ppthanh2810/capstone_project/stage3_navigation/README.md

# `stage3_navigation`: lập đường A\* + DWB tự né vật cản

Package này giúp robot **tự đi tới một đích** chọn trên RViz, theo hai lớp:

| Lớp | Làm gì | Biết gì |
|---|---|---|
| **A\*** (toàn cục) | Tìm **một** đường từ robot tới đích, **một lần** cho mỗi goal | Chỉ bản đồ tĩnh (`/map`) |
| **DWB** (cục bộ) | Mỗi 0.1 s chọn vận tốc (v, ω) để bám đường A\* và **tự né vật cản** | Vật cản LiDAR đang thấy (local costmap 2 × 2 m) |

- **Không có replanning.** Đường A\* không đổi trong cả lần bám. Vật cản mới chỉ do DWB xử lý (mục 9).
- Bộ điều khiển mặc định là **CustomDWB** (`stage3_navigation::DwbController`, tự viết). Nav2 DWB vẫn giữ để so sánh.
- Tính năng replan (commit `0d553eb`, 2026-10-15) đã được gỡ ngày 2026-10-19. Code và tham số CustomDWB = bản trước đó
  (`a7c59a1`), cộng cổng serial mới. Từ 2026-10-20 có thêm lớp camera (M2, `camera:=true`); ảnh camera hiện ngay trong `planning.rviz`.

> ⚠️ **Mọi launch ở đây đều include Stage 2**, nên bật LiDAR, IMU, **motor** và tay PS4 (trừ `stage2:=false`).
> `navigation_enabled:=false` (mặc định) chỉ ngắt **lệnh của DWB** khỏi motor; tay PS4 vẫn lái được.
> `navigation_enabled:=true` (DWB lái motor thật): kê bánh / giữ E-stop.

---

## Mục lục
1. Các file chính
2. Kiến trúc và luồng dữ liệu
   - 2.1 Sơ đồ tổng
   - 2.2 Node của stage 3
   - 2.3 Topic, action, service chính
   - 2.4 Lifecycle (thứ tự bật)
3. `launch/planning.launch.py`: chỉ lập đường A\*
4. `launch/navigation.launch.py`: A\* + DWB
5. Các trường hợp chạy
   - 5.1 Quy trình chuẩn (C hoặc D)
   - 5.2 Lưu ý cho chế độ C (cách ly)
   - 5.3 Rollout trên robot (theo thứ tự)
6. `config/nav2_params.yaml`: tham số
   - 6.1 `planner_server` (A\*)
   - 6.2 `global_costmap` (cho A\*)
   - 6.3 `controller_server`
   - 6.4 `CustomDWB` (`stage3_navigation::DwbController`)
   - 6.5 `FollowPath` (Nav2 DWB, để so sánh)
   - 6.6 `local_costmap` (cho DWB)
   - 6.7 Lớp camera trong `local_costmap` (M2, tùy chọn)
   - 6.8 `goal_path_bridge`
7. `goal_path_bridge`: phân tích chi tiết
   - 7.1 Nhận goal (`onGoal`)
   - 7.2 Bắt đầu bám đường (`startFollow`)
   - 7.3 Trạng thái trên `/goal_path_bridge/follow_state`
   - 7.4 Giám sát (timer 200 ms, `watchFollow`, chỉ khi đang bám)
   - 7.5 Kết quả FollowPath
   - 7.6 Tắt node
8. CustomDWB: phân tích chi tiết
   - 8.1 Khi nhận đường (`setPlan`)
   - 8.2 Một chu kỳ (`computeVelocityCommands`, 10 Hz)
   - 8.3 controller_server làm gì với lỗi của plugin
   - 8.4 Sơ đồ luồng một chu kỳ
   - 8.5 Vòng phản hồi điều khiển
   - 8.6 Vai trò của từng nhóm tham số
   - 8.7 Ví dụ: CustomDWB xử lý khi gặp vật cản
   - 8.8 Quan hệ quan trọng khi tuning
9. DWB tự né vật cản
   - 9.1 Cơ chế
   - 9.2 Tuning 2026-10-21 (mô phỏng, chưa thử trên robot)
   - 9.3 Né được và không né được
   - 9.4 Tham số ảnh hưởng tới khả năng né
   - 9.5 Cách thử né vật cản trên robot
   - 9.6 Vật cản LiDAR không thấy: lớp camera (M2)
10. Các tình huống và cách hệ thống phản ứng
11. Thời gian truyền và phản hồi
12. Kết quả trên robot
13. Theo dõi và debug
14. Test
15. Giới hạn đã biết

---

## 1. Các file chính

| File | Vai trò |
|---|---|
| `launch/planning.launch.py` | Stage 2 + A\* + RViz (chỉ lập đường, **không** có DWB) |
| `launch/navigation.launch.py` | `planning.launch.py` + DWB + local costmap |
| `config/nav2_params.yaml` | Mọi tham số: planner, 2 costmap, bridge, controller, DWB |
| `src/goal_path_bridge.cpp` | Node điều phối: goal → A\* → FollowPath, giám sát |
| `src/dwa_core.cpp` | Thuật toán CustomDWB (không phụ thuộc ROS) |
| `src/dwb_controller.cpp` | Vỏ ROS của CustomDWB (plugin Nav2) |
| `include/stage3_navigation/dwa_core.hpp` | Tham số mặc định `DwbParams`, khai báo thuật toán |
| `include/stage3_navigation/dwb_controller.hpp` | Khai báo plugin |
| `dwb_controller_plugin.xml` | Đăng ký plugin với pluginlib |
| `src/camera_fusion.cpp` + `.hpp` | Luật hợp nhất camera + LiDAR (M2, không phụ thuộc ROS) |
| `src/fusion_layer.cpp` + `.hpp` | Plugin costmap `FusionLayer` (vỏ ROS) |
| `fusion_layer_plugin.xml` | Đăng ký `FusionLayer` với pluginlib |
| `config/camera_fusion.yaml` | Thêm `fusion_layer` vào local costmap (nạp chồng) |
| `config/camera_voxel.yaml` | Thêm `VoxelLayer` của Nav2 (đối chứng) |
| `launch/camera.launch.py` | Driver RealSense D435 (point cloud, không TF) |
| `rviz/planning.rviz` | RViz duy nhất: map, costmap, đường đi + ảnh màu, point cloud camera |

---

## 2. Kiến trúc và luồng dữ liệu

### 2.1 Sơ đồ tổng

```text
                       (Stage 2: AMCL hoặc slam_toolbox)        (Stage 1: EKF)
                          /map, TF map → odom              TF odom → base_footprint, /odometry/filtered
                                   │                                     │
RViz 2D Goal Pose ──/goal_pose──> goal_path_bridge ──action /compute_path_to_pose──> planner_server (A*)
                                   │   ▲                                               │ global_costmap
                                   │   └────────────── đường A* ───────────────────────┘ (static + inflation)
                                   │
                                   ├──> /global_path (RViz)
                                   │
            (chỉ khi ~/follow hoặc auto_follow)
                                   │
                                   └──action /follow_path──> controller_server (10 Hz)
                                                              │  plugin CustomDWB hoặc FollowPath (Nav2 DWB)
                                                              │  local_costmap ← /scan_filtered (né vật cản)
                                                              ▼
                                          "cmd_vel" ──> /cmd_vel_dwb  (navigation_enabled:=false, không ai nghe)
                                                   └──> /cmd_vel_nav  (navigation_enabled:=true)
                                                              │
                                                    twist_mux (ưu tiên 10; PS4 = 100)
                                                              │
                                                       /cmd_vel_out → zlac8015d_move → motor

/localization/status (monitor) ──> goal_path_bridge   (cho phép / hủy bám đường)
/global_costmap/costmap        ──> goal_path_bridge   (giải thích khi A* thất bại)
```

### 2.2 Node của stage 3

| Node | Có trong | Loại |
|---|---|---|
| `planner_server` (+ `global_costmap`) | planning, navigation | lifecycle |
| `lifecycle_manager_planning` | planning, navigation | – |
| `goal_path_bridge` | planning (A\* only) hoặc navigation (có FollowPath) | node thường |
| `controller_server` (+ `local_costmap`) | navigation | lifecycle |
| `lifecycle_manager_navigation` | navigation | – |
| `rviz2_planning` | cả hai (`rviz:=true`) | – |

Stage 3 **không phát TF**, không có BT navigator, không gọi `NavigateToPose`. Mọi thứ do `goal_path_bridge` điều phối.

### 2.3 Topic, action, service chính

| Tên | Loại | Từ → tới |
|---|---|---|
| `/goal_pose` | topic `PoseStamped` | RViz → bridge |
| `/compute_path_to_pose` | action | bridge → planner_server |
| `/global_path` | topic `Path` (transient_local) | bridge → RViz |
| `/plan` | topic `Path` | planner_server (tự phát) |
| `/follow_path` | action | bridge → controller_server |
| `/goal_path_bridge/follow` | service `Trigger` | người dùng → bridge (bắt đầu bám) |
| `/goal_path_bridge/cancel` | service `Trigger` | người dùng → bridge (dừng) |
| `/goal_path_bridge/follow_state` | topic `String` (transient_local) | bridge → người dùng |
| `/cmd_vel_dwb` hoặc `/cmd_vel_nav` | topic `Twist` | controller_server → (không ai) / twist_mux |
| `/local_plan` | topic `Path` | plugin đang chạy → RViz |
| `/CustomDWB/state` | topic `DiagnosticStatus` | CustomDWB → debug |
| `/CustomDWB/trajectories` | topic `MarkerArray` | CustomDWB → RViz |
| `/CustomDWB/local_path` | topic `Path` | CustomDWB → RViz |

### 2.4 Lifecycle (thứ tự bật)
- `lifecycle_manager_planning` bật `planner_server`. `lifecycle_manager_navigation` bật `controller_server`.
  Cả hai `autostart: true`.
- Costmap chỉ khởi động xong khi có TF tới `base_footprint`:
  - global costmap cần `map → base_footprint`. Ở chế độ localization, TF này **chỉ có sau khi đặt 2D Pose Estimate**
    (AMCL mới phát `map → odom`);
  - vì thế `bond_timeout: 0.0` (tắt bond), để lifecycle manager không coi việc chờ TF là node chết.
- Chưa đặt pose thì gửi goal sẽ bị báo `planner_server action not available`.

---

## 3. `launch/planning.launch.py`: chỉ lập đường A\*

**Vai trò:** chạy **một** bringup Stage 2 + `planner_server` + `global_costmap` + `goal_path_bridge` (A\* only) + RViz.
Không có lệnh vận tốc nào.

```bash
ros2 launch stage3_navigation planning.launch.py                              # localization (mặc định)
ros2 launch stage3_navigation planning.launch.py mode:=mapping allow_unknown:=true
```

| Đối số | Mặc định | Ý nghĩa |
|---|---|---|
| `mode` | `localization` | `localization` (AMCL) hoặc `mapping` (slam_toolbox); khác → lỗi |
| `serial_port` | `/dev/ttyUSB2` | Cổng LiDAR |
| `imu_port` | `/dev/ttyUSB0` | Cổng IMU |
| `map` | `~/capstone_ws/capstone_project/maps/map.yaml` | Bản đồ (localization) |
| `csm` | **`true`** | 2D Pose Estimate qua CSM (localization) |
| `monitor` | **`true`** | Chạy `localization_monitor` (localization) |
| `params_file` | `config/nav2_params.yaml` | File tham số |
| `allow_unknown` | `false` | A\* được đi qua vùng unknown |
| `stage2` | `true` | `false`: không chạy Stage 2 (test offline) |
| `goal_path_bridge` | `true` | `navigation.launch.py` đặt `false` (chạy bridge riêng) |
| `rviz` | `true` | Mở `planning.rviz` |
| `log_level` | `info` | Mức log |

Cách hoạt động:
- Hai `include_stage2(...)` có điều kiện: chỉ đúng **một** cái chạy theo `mode`. Nhờ vậy chỉ có một nguồn
  `map → odom`, một driver motor, một EKF.
- Stage 2 bị đặt `rviz:=false`: chỉ có một RViz.
- `csm` và `monitor` chỉ có tác dụng khi `mode:=localization`. Ở stage 3 chúng **mặc định bật**; ở stage 2 mặc
  định tắt.
- `allow_unknown` ghi đè `GridBased.allow_unknown` của planner.
- RViz: topic `/initialpose` (công cụ 2D Pose Estimate) được remap:
  - `mode:=localization csm:=true` → `/initialpose_guess` (qua CSM);
  - còn lại → `/initialpose` (thẳng vào AMCL; ở mapping không ai dùng).
- Bridge chạy với `auto_follow: false` (ở đây không có controller).

---

## 4. `launch/navigation.launch.py`: A\* + DWB

**Vai trò:** include `planning.launch.py` (với `goal_path_bridge:=false`), rồi thêm `controller_server`,
`lifecycle_manager_navigation` và một `goal_path_bridge` có FollowPath.

```bash
ros2 launch stage3_navigation navigation.launch.py                          # CustomDWB, cách ly motor
ros2 launch stage3_navigation navigation.launch.py local_planner:=nav2_dwb  # Nav2 DWB để so sánh
ros2 launch stage3_navigation navigation.launch.py navigation_enabled:=true # DWB lái motor thật
```

Có đủ đối số chung của `planning.launch.py` (truyền nguyên xuống), cộng thêm:

| Đối số | Mặc định | Ý nghĩa |
|---|---|---|
| `local_planner` | `custom` | `custom` = CustomDWB; `nav2_dwb` = Nav2 DWB; khác → lỗi |
| `navigation_enabled` | `false` | `true`: lệnh DWB → `/cmd_vel_nav` → motor |
| `auto_follow` | `false` | `true`: A\* xong là bám đường ngay |
| `camera` | `false` | `true`: chạy driver RealSense (**thiết bị thật**), ảnh màu 424×240@15 bật luôn |
| `camera_layer` | `auto` | `fusion` / `voxel` / `none`; `auto` = `fusion` nếu `camera:=true` |

Những gì launch tự đặt:

| Đặt gì | Giá trị |
|---|---|
| Remap `cmd_vel` của controller_server | `/cmd_vel_nav` nếu `navigation_enabled`, ngược lại `/cmd_vel_dwb` |
| Bridge `controller_id` | `CustomDWB` (custom) / `FollowPath` (nav2_dwb) |
| Bridge `require_localized` | `true` chỉ khi `mode:=localization` **và** `monitor:=true` |
| Bridge `auto_follow` | = `auto_follow` |

- Khi khởi động, launch in một dòng `LogInfo` cho biết chế độ vận tốc (cách ly hay lái motor).
- `controller_server` luôn nạp **cả hai** plugin. `controller_id` trong goal FollowPath chọn plugin nào chạy.

---

## 5. Các trường hợp chạy

| # | Lệnh | Robot làm gì | Dùng khi |
|---|---|---|---|
| A | `planning.launch.py` | Chỉ vẽ đường A\* | Kiểm tra bản đồ, A\* |
| B | `planning.launch.py mode:=mapping allow_unknown:=true` | A\* trên bản đồ đang vẽ | Thử A\* khi chưa có bản đồ |
| C | `navigation.launch.py` | DWB tính lệnh nhưng **không tới motor** | Xem lệnh DWB an toàn |
| D | `navigation.launch.py navigation_enabled:=true` | DWB **lái motor** | Thử thật (kê bánh / E-stop) |
| E | `... local_planner:=nav2_dwb` | Như C/D với Nav2 DWB | So sánh |
| F | `... auto_follow:=true` | A\* xong là bám ngay | Bỏ bước gọi `follow` |
| G | `... monitor:=false` | Không đòi LOCALIZED | Thử DWB né vật cản (mục 9) |
| H | `... stage2:=false rviz:=false` | Không phần cứng | Cần nguồn `/map`, TF, scan, odom bên ngoài (vd. bag); repo không còn mô phỏng |

### 5.1 Quy trình chuẩn (C hoặc D)
1. Chạy launch. Kiểm tra IMU: `ros2 topic hz /imu_odom` ≈ 50 Hz (mục 10, dòng "IMU mất dữ liệu").
   Chờ log `Managed nodes are active` (có thể chỉ xuất hiện sau bước 2).
2. RViz **2D Pose Estimate**: click vị trí thật của robot. CSM chỉnh lại pose, AMCL bắt đầu phát TF.
3. Chờ `/localization/status` = `LOCALIZED`. Nếu CSM báo `AMBIGUOUS`, AMCL nhận covariance rộng (std_xy ~0.5 m) →
   monitor `UNCERTAIN` → `follow` bị từ chối. Nhích robot bằng PS4 vài chục cm để AMCL hội tụ, hoặc đặt pose lại.
4. RViz **2D Goal Pose**: chọn đích. Thấy `/global_path` hiện lên.
5. Bắt đầu bám (bỏ qua bước này nếu `auto_follow:=true`):
   ```bash
   ros2 service call /goal_path_bridge/follow std_srvs/srv/Trigger
   ```
6. Theo dõi:
   ```bash
   ros2 topic echo /goal_path_bridge/follow_state
   ```
   Ở chế độ C, xem thêm `ros2 topic echo /cmd_vel_dwb`.
7. Dừng:
   ```bash
   ros2 service call /goal_path_bridge/cancel std_srvs/srv/Trigger
   ```
   Hoặc Ctrl+C, hoặc E-stop.

### 5.2 Lưu ý cho chế độ C (cách ly)
Robot không chạy thật, nên vận tốc đo luôn khoảng 0. DWB vẫn ra lệnh, nhưng **sau 10 s progress checker báo
`Failed to make progress`** → `ABORTED`. **Đây là bình thường.** Chế độ này dùng để xem lệnh đầu tiên, pha xoay và
quỹ đạo trên RViz.

### 5.3 Rollout trên robot (theo thứ tự)
1. Chế độ C: xem `/cmd_vel_dwb` và RViz.
2. Chế độ D với **bánh kê khỏi mặt đất**, tay ở E-stop.
3. Chế độ D trên sàn, đi chậm, khu vực trống.
4. Thử né vật cản: chế độ D + `monitor:=false`, có người giám sát (mục 9).

---

## 6. `config/nav2_params.yaml`: tham số

### 6.1 `planner_server` (A\*)

| Tham số | Giá trị | Ý nghĩa |
|---|---|---|
| `planner_plugins` | `["GridBased"]` | Một planner |
| `GridBased.plugin` | `nav2_navfn_planner/NavfnPlanner` | NavFn của Nav2 |
| `use_astar` | `true` | A\* (không phải Dijkstra) |
| `allow_unknown` | `false` | Không đi qua vùng unknown |
| `tolerance` | `0.0` | Đích phải ở ô hợp lệ; không tự dời đích |
| `use_final_approach_orientation` | `false` | Hướng cuối = hướng Goal Pose |
| `expected_planner_frequency` | 1.0 | Chỉ để cảnh báo |

A\* chạy **chỉ khi có goal mới**. Không lập lại định kỳ, không lập lại khi gặp vật cản.

### 6.2 `global_costmap` (cho A\*)

| Tham số | Giá trị |
|---|---|
| `global_frame` / `robot_base_frame` | `map` / `base_footprint` |
| `robot_radius` | 0.20 m |
| `resolution` | 0.05 m |
| `rolling_window` | `false` (kích thước theo `/map`) |
| `update_frequency` / `publish_frequency` | 1.0 / 1.0 Hz |
| `transform_tolerance` | 0.5 s |
| `track_unknown_space` | `true` |
| `trinary_costmap` | `true` |
| `lethal_cost_threshold` / `unknown_cost_value` | 100 / 255 |
| `always_send_full_costmap` | `true` |
| `plugins` | `static_layer`, `inflation_layer` |

- **`static_layer`**: lấy `/map`, transient_local, không nhận `/map_updates`.
- **`inflation_layer`**: `inflation_radius 0.40`, `cost_scaling_factor 3.0`, không inflate vùng unknown.

Hệ quả:
- A\* **chỉ thấy bản đồ tĩnh**, không biết vật cản mới (người, thùng…).
- Ô cách tường < 0.20 m là inscribed (99), A\* coi như vật cản → A\* đi được khe **≥ 0.40 m**.
- Đường A\* ưu tiên đi giữa lối, cách xa tường (nhờ inflation tới 0.40 m).

Chi phí theo khoảng cách `d` tới tường (`252 · exp(−3.0 · (d − 0.20))`):

| `d` | Chi phí |
|---|---|
| ≤ 0.20 m | 253 (A\* không đi) |
| 0.25 m | ~218 |
| 0.30 m | ~187 |
| 0.35 m | ~161 |
| 0.40 m | ~138 |
| > 0.40 m | 0 |

- Đổi 0.55 → 0.40 m (2026-10-20): ngoài 0.40 m A\* không còn bị đẩy ra xa tường. Đường ngắn hơn, đi sát tường hơn
  ở lối rộng.
- Khe hẹp nhất A\* đi được **không đổi** (≥ 0.40 m, do `robot_radius`). CustomDWB cần khe ≥ ~0.55–0.6 m (nội tiếp 0.25 m, mục 6.6).

### 6.3 `controller_server`

| Tham số | Giá trị | Ý nghĩa |
|---|---|---|
| `controller_frequency` | 10 Hz | Một chu kỳ điều khiển = 0.1 s |
| `odom_topic` | `/odometry/filtered` | Vận tốc đo |
| `min_x_velocity_threshold` | 0.001 | Vận tốc đo nhỏ hơn → 0 |
| `min_theta_velocity_threshold` | 0.001 | – |
| `min_y_velocity_threshold` | 0.5 | Robot vi sai: bỏ vy |
| `failure_tolerance` | 0.3 s | Plugin lỗi liên tục quá 0.3 s → abort |
| `controller_plugins` | `["FollowPath", "CustomDWB"]` | Nạp cả hai |

**Progress checker** (`SimpleProgressChecker`):
- `required_movement_radius` 0.25 m, `movement_time_allowance` 10 s.
- Không đi được 0.25 m trong 10 s → abort `Failed to make progress`.
- **Xoay tại chỗ không tính là đi.**

**Goal checker** (`SimpleGoalChecker`, tên `general_goal_checker`):
- `xy_goal_tolerance` 0.15 m, `yaw_goal_tolerance` 0.25 rad (~14°).
- `stateful: true`: lần đầu vào trong 0.15 m thì chốt vị trí, sau đó chỉ còn xét hướng.

### 6.4 `CustomDWB` (`stage3_navigation::DwbController`)

**Giới hạn động học** (giá trị khởi đầu, chưa đo đầy đủ):

| Tham số | Giá trị |
|---|---|
| `max_vel_x` | 0.3 m/s (cũ 0.15) |
| `min_vel_x` | 0.0 (**không lùi**: phía sau không có LiDAR) |
| `max_vel_theta` | 1.0 rad/s (cũ 0.5) |
| `min_in_place_vel_theta` | 0.1 rad/s |
| `acc_lim_x` / `decel_lim_x` | 0.5 / 0.5 m/s² |
| `acc_lim_theta` / `decel_lim_theta` | 2.0 / 2.0 rad/s² (cũ 1.0) |

Tăng / giảm thì sao (nên đặt **≤ khả năng thật** của robot; chưa đo):
- `max_vel_x` — tốc độ tiến tối đa, cũng quyết định độ dài cung dò vật cản (`max_vel_x × sim_time`).
  - ↑: nhanh hơn, nhìn xa hơn; nhưng quãng phanh dài hơn (v²/2·decel), ít thời gian phản ứng với vật cản bất ngờ. Quét 2026-10-26: 0.4 m/s né **kém** hơn (24/35 so với 34/35, mục 9).
  - ↓: an toàn, êm; cung dò ngắn lại → phải tăng `sim_time` theo (0.2 m/s → 3.0 s), nếu không né kém.
- `min_vel_x` — giữ 0.0. Âm = cho lùi, nhưng phía sau không có LiDAR (vùng sau luôn FREE) → **không được** đổi.
- `max_vel_theta` — tốc độ quay tối đa (cả khi xoay tại chỗ).
  - ↑: rẽ gắt, đường vòng ngắn; lớn quá thì AMCL/EKF dễ mất chính xác khi quay nhanh, dễ overshoot.
  - ↓: quay êm, định vị ổn hơn; nhưng bán kính rẽ lớn → khó né trong chỗ hẹp.
- `min_in_place_vel_theta` — ω nhỏ nhất khi xoay tại chỗ (để thắng ma sát / vùng chết của bánh).
  - ↑: không bị "kẹt" khi còn lệch ít, nhưng dễ vượt qua góc đích rồi quay ngược.
  - ↓: dừng xoay chính xác hơn; quá nhỏ thì bánh không nhúc nhích (lệnh 0.1 rad/s ≈ vài bước RPM).
- `acc_lim_x` / `decel_lim_x` — độ rộng cửa sổ v mỗi chu kỳ (± acc·dt = ±0.05 m/s ở 10 Hz). `decel_lim_x` còn dùng để tính đuôi phanh khi kiểm tra va chạm.
  - ↑: tăng/giảm tốc nhanh hơn. Nếu lớn hơn khả năng thật (driver ramp 500 ms) → mô phỏng tin rằng phanh kịp nhưng thực tế không → **nguy hiểm**.
  - ↓: êm hơn; `decel_lim_x` nhỏ = giả định phanh chậm → dừng xa vật cản hơn (an toàn hơn, nhưng thận trọng quá thì khó đi qua chỗ hẹp).
- `acc_lim_theta` / `decel_lim_theta` — độ rộng cửa sổ ω mỗi chu kỳ (2.0 → ±0.2 rad/s/chu kỳ). **Quan trọng nhất cho né vật cản** (mục 9).
  - ↑: có quỹ đạo rẽ đủ mạnh để chi phí vật cản khác nhau → né được; lớn hơn thực tế thì robot không theo kịp lệnh.
  - ↓ (1.0 cũ = ±0.1 rad/s): mọi ứng viên gần giống nhau → không né được, chỉ dừng.

**Lấy mẫu và mô phỏng:**

| Tham số | Giá trị | Ý nghĩa |
|---|---|---|
| `vx_samples` × `vtheta_samples` | 20 × 21 | ≈ 420–440 ứng viên mỗi chu kỳ |
| `sim_time` | 2.0 s | Nhìn trước (0.3 m/s → ~0.6 m) |
| `sim_granularity` | 0.05 s | Bước mô phỏng tối đa |
| `control_latency` | 0.2 s | Trễ lệnh → bánh (đo từ bag 2026-10-14, driver tăng/giảm tốc 200 ms; nay driver mặc định 500 ms) |
| `stopping_margin` | 0.02 m | Khoảng trống thêm sau khi phanh (cũ 0.05) |

Tăng / giảm thì sao:
- `vx_samples` × `vtheta_samples` — số ứng viên v × ω trong cửa sổ (cộng thêm v = 0, ω = 0).
  - ↑: chọn được lệnh tinh hơn (nhất là ω khi lách), nhưng tốn CPU; tải bị chặn ≤ 100 000 pose/chu kỳ, vượt → bị từ chối.
  - ↓: nhanh hơn, nhưng lưới thô → có thể bỏ lỡ khe né duy nhất, lệnh giật bậc.
- `sim_time` — thời gian nhìn trước của mỗi quỹ đạo.
  - ↑: thấy vật cản sớm, rẽ từ xa; nhưng quỹ đạo dài dễ "đụng" vật cản ở xa → loại bỏ cứng nhiều ứng viên, khó đi qua chỗ hẹp/khúc cua; tốn CPU.
  - ↓: linh hoạt ở chỗ hẹp, nhưng thấy vật cản muộn → phanh gấp hoặc đứng im.
- `sim_granularity` — bước mô phỏng tối đa (thật sự còn bị chặn ≤ nửa ô costmap).
  - ↑: nhẹ CPU; vì bước còn bị chặn theo nửa ô nên không bỏ sót ô (ở 0.3 m/s, 0.05 s ≈ 0.015 m < 0.025 m).
  - ↓: chính xác hơn rất ít, tốn CPU.
- `control_latency` — trễ từ lúc gửi lệnh tới lúc bánh thực hiện; mô phỏng giữ lệnh cũ trong khoảng này.
  - ↑ (so với thực): thận trọng hơn, dừng/rẽ sớm hơn; quá lớn → robot phản ứng chậm, xoay thiếu góc.
  - ↓ (so với thực): mô phỏng lạc quan hơn thực tế → phanh muộn, xoay lố. **Không nên giảm** khi chưa đo lại (driver nay 500 ms, có thể trễ thật > 0.2 s).
- `stopping_margin` — khoảng trống bắt buộc phía trước sau khi phanh xong.
  - ↑: dừng xa vật cản hơn, an toàn hơn; nhưng khó đi qua khe hẹp, dễ `holding position`.
  - ↓ (đã 0.02): đi sát hơn — **không nên giảm thêm**.

**Vận tốc gốc của cửa sổ:**

| Tham số | Giá trị |
|---|---|
| `velocity_reference` | `command` |
| `max_feedback_gap_x` | 0.15 m/s |
| `max_feedback_gap_theta` | 0.5 rad/s |

Cửa sổ động (v ± acc·dt, ω ± acc·dt) được đặt quanh một "vận tốc gốc":
- `velocity_reference`
  - `command`: gốc = lệnh trước (kẹp quanh vận tốc đo). Lệnh đổi đúng `acc/decel_lim` mỗi chu kỳ, không bị trễ odometry làm chậm → không xoay lố.
  - `measured`: gốc = vận tốc đo từ `/odometry/filtered`. Vì odom trễ ~0.2 s, lệnh chỉ nhích dần → phanh/giảm quay rất chậm (robot 2026-10-14: xoay lố ~50°). Chỉ dùng để so sánh.
- `max_feedback_gap_x` / `max_feedback_gap_theta` — lệnh trước được phép cách vận tốc đo tối đa bao nhiêu (chỉ khi `command`). Bảo vệ khi robot không theo lệnh (PS4 chiếm `twist_mux`, bánh kẹt, nâng bánh).
  - ↑: gốc bám lệnh hơn, đổi tốc nhanh; nhưng khi robot thật không chạy, gốc trôi xa thực tế → lệnh nhảy lớn khi robot được thả.
  - ↓: gốc bám vận tốc đo hơn → an toàn khi robot bị chặn, nhưng tiến dần về kiểu `measured` (chậm, dễ lố). Nên ≥ vài lần `acc·dt` (0.05 m/s, 0.2 rad/s).

**Bám đường:**

| Tham số | Giá trị | Ý nghĩa |
|---|---|---|
| `local_plan_length` | 1.5 m | Đoạn đường phía trước được xét |
| `carrot_distance` | 0.8 m | Điểm dẫn hướng ("cà rốt") |
| `closest_search_distance` | 1.0 m | Cửa sổ tìm tiến trình |
| `max_path_deviation` | 1.0 m | Lệch đường hơn → dừng |

Tăng / giảm thì sao:
- `local_plan_length` — đoạn đường A\* cắt ra để tính `path_distance` và đặt cà rốt (bị cắt thêm ở mép local costmap 2 × 2 m).
  - ↑: thấy khúc cua sớm hơn, nhưng trên 1 m thường bị mép costmap cắt nên ít tác dụng.
  - ↓: robot chỉ "nhìn" đoạn ngắn → bám sát đường hơn nhưng dễ lắc ở khúc cua. Phải luôn ≥ `carrot_distance`.
- `carrot_distance` — điểm robot cố hướng tới.
  - ↑: đi mượt, cắt góc nhiều hơn; khi né, cà rốt nằm sau vật cản nên kéo robot đi tiếp (quét 2026-10-26: 0.4–1.2 m né gần như nhau, mục 9).
  - ↓: bám sát đường A\* (ít cắt góc), nhưng hay lắc trái/phải và dễ bị kéo ngược về vật cản khi đang vòng.
- `closest_search_distance` — robot chỉ tìm "mình đang ở đâu trên đường" trong cửa sổ này phía trước tiến trình hiện tại.
  - ↑: không mất dấu khi robot bị đẩy lệch xa hoặc tiến nhanh, nhưng dễ nhảy tắt sang nhánh khác của đường chữ U / tự cắt.
  - ↓: chống nhảy nhánh tốt hơn, nhưng sau một đường vòng dài tiến trình có thể bị "kẹt lại" phía sau.
- `max_path_deviation` — lệch khỏi đường A\* quá mức này → `PlannerException` → abort.
  - ↑: cho phép đường vòng né rộng hơn; nhưng robot có thể đi khá xa đường đã duyệt trước khi bị dừng.
  - ↓: an toàn, dừng sớm khi lạc; quá nhỏ (< ~0.6 m) thì mọi lần né đều bị abort.

**Pha xoay và đích:**

| Tham số | Giá trị | Ý nghĩa |
|---|---|---|
| `rotate_to_heading_angle` | 2.5 rad | Lệch hơn → xoay tại chỗ (ra khi < 1.25) |
| `rotate_gain` | 1.5 | ω = gain × sai số góc |
| `xy_goal_tolerance` / `yaw_goal_tolerance` | 0.15 / 0.25 | Dự phòng (thật lấy từ goal checker) |
| `goal_tolerance_fraction` | 0.9 | Dùng 0.9 × dung sai bên trong |
| `goal_latch_release_margin` | 0.05 m | Trôi ra ngoài xy + 0.05 → tiếp cận lại |

Tăng / giảm thì sao:
- `rotate_to_heading_angle` — ngưỡng vào pha ROTATE_TO_PATH (xoay tại chỗ); ra khi lệch < ½ ngưỡng.
  - ↑ (tối đa π): gần như luôn rẽ bằng cung vừa đi vừa quay; không bị ép quay đầu về vật cản giữa lúc vòng. Đổi lại cua gắt (135°) đi thành cung rộng, cần chỗ.
  - ↓ (ví dụ 0.8 cũ): xoay tại chỗ nhiều hơn → gọn ở chỗ hẹp, nhưng giữa lúc né dễ quay lại phía vật cản.
- `rotate_gain` — độ "gắt" khi xoay tại chỗ (ω vẫn bị chặn bởi `max_vel_theta` và đường phanh √(2·decel·sai số)).
  - ↑: xoay nhanh hơn khi còn lệch ít, nguy cơ vượt quá đích (overshoot) nếu trễ lớn.
  - ↓: dừng xoay êm hơn nhưng chậm; quá nhỏ thì ω chạm `min_in_place_vel_theta` 0.1 và bò rất lâu ở cuối.
- `xy_goal_tolerance` / `yaw_goal_tolerance` — chỉ dùng khi không đọc được goal checker (bình thường lấy 0.15 / 0.25 của `general_goal_checker`).
  - ↑: tới đích sớm, kém chính xác. ↓: chính xác hơn nhưng dễ lượn quanh đích / hết thời gian.
- `goal_tolerance_fraction` — CustomDWB nhắm vào 0.9 × dung sai, để goal checker chắc chắn cũng thấy "đạt".
  - ↑ (→ 1.0): dừng sát mép dung sai, có thể goal checker chưa công nhận (do sai số) → robot đứng mà chưa SUCCEEDED.
  - ↓: chắc chắn hơn nhưng phải đi/xoay chính xác hơn, lâu hơn.
- `goal_latch_release_margin` — vùng trễ (hysteresis) để không nhảy qua lại giữa ROTATE_TO_GOAL và FOLLOW_PATH.
  - ↑: ít nhảy pha hơn, nhưng robot trôi xa hơn mới chịu tiến lại.
  - ↓ (→ 0): phản ứng sớm, dễ dao động pha ngay mép dung sai.

**Trọng số chi phí** (nhỏ hơn = tốt hơn; tuning né vật cản 2026-10-21, xem mục 9):

| Tham số | Giá trị |
|---|---|
| `path_distance_scale` | 0.5 |
| `carrot_distance_scale` | 2.0 |
| `heading_scale` | 0.3 |
| `obstacle_scale` | 4.0 |
| `speed_scale` | 1.5 |
| `oscillation_scale` | 1.0 |

Tổng chi phí = Σ trọng số × thành phần. Chỉ **tỉ lệ giữa các trọng số** là quan trọng (nhân tất cả × 2 → không đổi gì).
Lưu ý đơn vị: `path` và `carrot` tính bằng mét, các thành phần còn lại chuẩn hóa 0..1.
- `path_distance_scale` — phạt điểm cuối quỹ đạo xa đường A\*.
  - ↑: bám sát đường, nhưng ngại lệch → khó né (dễ `holding position`).
  - ↓: dám lệch để né; quá nhỏ thì robot cắt góc, đi lệch đường nhiều.
- `carrot_distance_scale` — phạt điểm cuối xa cà rốt (lực "kéo về phía trước"). Phải có `path + carrot > 0`.
  - ↑: tiến về đích dứt khoát, ưu tiên đi nhanh và thẳng tới cà rốt.
  - ↓: kéo yếu, robot dễ đi chậm / lưỡng lự.
- `heading_scale` — phạt hướng đầu xe cuối quỹ đạo lệch so với hướng tới cà rốt.
  - ↑: đầu xe luôn chĩa về cà rốt, đi thẳng thớm; nhưng chống lại việc quay ngang để vòng vật cản.
  - ↓: cho phép đầu xe lệch tạm thời khi né; quá nhỏ thì có thể lượn rắn.
- `obstacle_scale` — phạt ô costmap đắt nhất dọc cung nhìn trước (vùng inflation).
  - ↑: tránh xa vật cản sớm và rộng hơn. Nếu không tăng `speed_scale` theo → chọn v = 0 (đứng im, vì v = 0 không bị tính chi phí này).
  - ↓: đi sát vật cản hơn, chỉ còn loại bỏ cứng (va chạm) bảo vệ.
- `speed_scale` — phạt đi chậm: (max_vel_x − v) / max_vel_x.
  - ↑: luôn cố chạy nhanh, không chịu đứng im trước vật cản; quá lớn thì lao nhanh cả ở chỗ hẹp.
  - ↓: chịu đi chậm / dừng → an toàn hơn nhưng dễ đứng yên rồi bị abort (`Failed to make progress`).
- `oscillation_scale` — phạt đổi chiều quay (trái ↔ phải) ngay sau một lần đổi chiều.
  - ↑: ít lắc trái-phải, nhưng có thể khóa chiều quay sai lâu hơn.
  - ↓ (0 = tắt): phản ứng linh hoạt hơn nhưng dễ lắc trước vật cản đối xứng.

**Chống dao động:** reset sau `oscillation_reset_dist` 0.05 m, `oscillation_reset_angle` 0.2 rad, hoặc
`oscillation_reset_time` 2.0 s.
- Sau một lần đổi chiều quay, phạt đổi chiều tiếp được giữ tới khi robot đi > dist **hoặc** quay > angle **hoặc** hết time.
- ↑ các ngưỡng: khóa chiều quay lâu hơn → ít lắc, nhưng chậm sửa nếu đã chọn sai bên để né.
- ↓ các ngưỡng: phạt hết sớm → gần như tắt chống dao động.

**An toàn dữ liệu:**

| Tham số | Giá trị | Ý nghĩa |
|---|---|---|
| `transform_tolerance` | 0.3 s | Thời gian **chờ** TF |
| `max_tf_age` | 1.0 s | Tuổi tối đa TF `map → odom` |
| `max_pose_age` | 0.5 s | Tuổi tối đa TF `odom → base_footprint` |
| `odom_timeout` | 0.5 s | `/odometry/filtered` im lặng hơn → dừng |
| `collision_check` | `auto` | Footprint tròn → chỉ xét ô tâm |
| `unknown_is_obstacle` | `true` | Không có tác dụng (local costmap không theo dõi unknown) |

Tăng / giảm thì sao (đây là tham số **an toàn**, chỉ nới khi có lý do rõ):
- `transform_tolerance` — thời gian chờ TF mới nhất trong một chu kỳ.
  - ↑: chịu được TF đến trễ, nhưng một chu kỳ có thể bị kéo dài (chu kỳ 0.1 s ở 10 Hz).
  - ↓: chu kỳ đúng hạn hơn, nhưng hay báo lỗi TF khi máy bận.
- `max_tf_age` — TF `map → odom` (AMCL) cũ hơn mức này → từ chối.
  - ↑: chịu được AMCL / LiDAR gián đoạn ngắn (AMCL gửi lại TF theo mỗi scan), nhưng dùng vị trí cũ lâu hơn.
  - ↓: dễ dừng oan khi AMCL bị chậm một nhịp.
- `max_pose_age` — TF `odom → base_footprint` (EKF 30 Hz) cũ hơn → từ chối.
  - ↑: chịu EKF giật, nhưng điều khiển theo vị trí cũ. ↓: dừng ngay khi EKF chậm.
- `odom_timeout` — không có `/odometry/filtered` lâu hơn → dừng.
  - ↑: ít dừng oan, nhưng nếu odom chết robot chạy "mù" lâu hơn. ↓: dừng nhanh, có thể dừng oan khi tải cao.
- `collision_check` — `auto` (tròn → `center`), `center` (chỉ ô tâm, nhanh; đúng khi inflation đã ≥ bán kính), `footprint` (xét cả viền; cần cho footprint đa giác, chậm hơn).
- `unknown_is_obstacle` — `true` = ô chưa biết là vật cản. Chỉ có tác dụng nếu bật `track_unknown_space` cho local costmap; khi đó `false` sẽ cho đi vào vùng chưa thấy (nguy hiểm, nhất là phía sau).

**Debug:** `publish_trajectories: true`, `trajectory_marker_stride: 4`, `debug_publish_rate: 5.0` Hz.
- `publish_trajectories` `false` → không vẽ quỹ đạo ứng viên trong RViz (bớt tải).
- `trajectory_marker_stride` ↑ → vẽ thưa hơn (1/4 ứng viên), nhẹ RViz; ↓ (1) → vẽ hết, dễ xem nhưng nặng.
- `debug_publish_rate` ↑ → `/CustomDWB/state` và marker cập nhật dày hơn (tốn CPU/băng thông); 0 → tắt (vẫn publish `/local_plan`). Không ảnh hưởng điều khiển.

Cả 45 tham số được kiểm tra khi configure và khi `ros2 param set`:
- phải hữu hạn và nằm trong miền giá trị;
- phải thỏa quan hệ với nhau (ví dụ `carrot_distance ≤ local_plan_length`);
- tải ≤ 100 000 pose mô phỏng mỗi chu kỳ.

Sai một cái thì cả lô bị từ chối, giữ giá trị cũ:

```bash
ros2 param set /controller_server CustomDWB.max_vel_x 0.12
```

### 6.5 `FollowPath` (Nav2 DWB, để so sánh)
- Giới hạn **cũ** của CustomDWB (không tuning theo 2026-10-21): `max_vel_x` 0.15, `max_vel_theta` 0.5, `acc_lim_x` 0.5,
  `decel_lim_x` −0.5 (Nav2 dùng số âm), `acc_lim_theta` 1.0, `sim_time` 1.7, `vx_samples` 20, `vtheta_samples` 20.
- Critics mặc định Humble: `RotateToGoal, Oscillation, BaseObstacle, GoalAlign, PathAlign, PathDist, GoalDist`.
- Trọng số: `PathAlign` 32, `GoalAlign` 24, `PathDist` 32, `GoalDist` 24, `RotateToGoal` 32, `BaseObstacle` 0.02.
- Khác CustomDWB: không có watchdog odometry, không mô phỏng trễ và đuôi phanh. Benchmark offline cũ (đã xoá): khi
  odometry ngừng, Nav2 DWB vẫn chạy tiếp tới đích.

### 6.6 `local_costmap` (cho DWB)

| Tham số | Giá trị |
|---|---|
| `global_frame` | `odom` |
| Kích thước | 2 × 2 m (40 × 40 ô), rolling window quanh robot |
| `resolution` | 0.05 m |
| `robot_radius` + `footprint_padding` | 0.20 + 0.05 m (nội tiếp **0.25 m**; cũ 0.10 / 0.30) |
| `update_frequency` / `publish_frequency` | 5.0 / 2.0 Hz |
| `transform_tolerance` | 0.3 s |
| `track_unknown_space` | `false` |
| `plugins` | `obstacle_layer`, (`fusion_layer`), `inflation_layer` |
| obstacle: nguồn | `/scan_filtered`, đánh dấu 2.5 m / xóa 3.0 m, `inf_is_valid: false` |
| obstacle: `expected_update_rate` | 0.5 s (scan cũ hơn → costmap "không current") |
| inflation | `inflation_radius 0.30` (cũ 0.45), `cost_scaling_factor 3.0` |

`fusion_layer` (camera) chỉ có khi `camera:=true` hoặc `camera_layer:=fusion` (mục 6.7). Không có camera thì chỉ
có LiDAR.

#### 6.6.1 Mỗi ô lưu gì

Mỗi ô là một số 0–255:

| Giá trị | Ý nghĩa |
|---|---|
| 254 `LETHAL` | Có vật cản trong ô |
| 253 `INSCRIBED` | Tâm robot ở đây → thân cách vật < 0.05 m (≤ 0.25 m) |
| 1–252 | Gần vật cản, càng gần càng cao |
| 0 `FREE` | Trống |

- Không dùng 255 (`NO_INFORMATION`): `track_unknown_space: false`, nên ô chưa ai thấy được coi là **trống**.
- Trên topic `/local_costmap/costmap` (OccupancyGrid) giá trị được đổi thang: 254 → 100, 253 → 99, 1–252 → 1–98.

#### 6.6.2 Bộ nhớ nằm ở đâu

Costmap tổng (master) **không tự nhớ gì**. Mỗi chu kỳ nó được xóa trắng rồi vẽ lại từ các lớp. Trí nhớ nằm trong
từng lớp:

| Lớp | Nhớ gì | Quên khi |
|---|---|---|
| `obstacle_layer` (LiDAR) | Lưới riêng 40 × 40, ô = LETHAL hoặc FREE | Tia LiDAR đi xuyên qua ô; ô ra khỏi cửa sổ 2 × 2 m; robot đè lên ô |
| `fusion_layer` (camera) | Danh sách ô trong frame `odom` + trạng thái từng ô | Camera nhìn xuyên 2 frame; 10 s không thấy lại; ô xa robot > 3 m |
| `inflation_layer` | Không nhớ, tính lại mỗi chu kỳ | — |

Hệ quả:
- **Vật LiDAR thấy được nhớ vô thời hạn** cho tới khi một tia LiDAR đi qua ô đó. Không có hết hạn theo thời gian
  (`observation_persistence: 0.0` chỉ nói buffer giữ scan mới nhất, không làm ô tự xóa).
- Vật đã đi ra **sau lưng** robot vẫn được nhớ, vì nửa sau scan là NaN, không xóa được. Nó chỉ mất khi ra khỏi
  cửa sổ (cách robot > ~1 m theo trục x hoặc y).
- Cửa sổ trượt theo robot. Phần mới lộ ra ở mép được điền **FREE**. Quay lại chỗ cũ thì vật LiDAR đã quên phải được
  quét lại.
- Bộ nhớ camera không gắn với cửa sổ: ô camera trong bán kính 3 m vẫn được giữ khi ra khỏi cửa sổ, và hiện lại nếu
  robot quay về (trừ khi đã hết 10 s).

#### 6.6.3 Một chu kỳ cập nhật (5 Hz, mỗi 0.2 s)

Luồng cập nhật của `local_costmap` chạy độc lập với controller:

```
1. Dời cửa sổ về quanh robot (TF odom → base_footprint)
2. updateBounds từng lớp:
     obstacle_layer : lấy scan mới nhất → XÓA theo tia → ĐÁNH DẤU điểm cuối tia
     fusion_layer   : xử lý cloud còn chờ TF → hết hạn ô cũ → chọn ô sẽ vẽ
3. Xóa trắng master (FREE)
4. updateCosts theo thứ tự plugins:
     obstacle_layer : chép lưới của nó vào master, lấy max; xóa ô dưới thân robot
     fusion_layer   : ghi LETHAL vào ô camera đã xác nhận (chỉ tăng, không bao giờ hạ)
     inflation_layer: từ mọi ô LETHAL, tô chi phí giảm dần tới 0.30 m
5. Kiểm tra "current": scan ≤ 0.5 s và (nếu có camera) cloud ≤ 1.0 s
```

- Controller (10 Hz) đọc master mới nhất. Nó không chờ chu kỳ costmap.
- Bất kỳ lớp nào **không current** → `controller_server` ngừng gọi controller, không gửi lệnh → robot dừng nhờ
  timeout 0.5 s của `twist_mux` / watchdog driver (mục 15).
- `/local_costmap/costmap` chỉ phát 2 Hz để vẽ RViz. RViz chậm hơn costmap thật.

#### 6.6.4 LiDAR: đánh dấu và xóa (`obstacle_layer`)

Với mỗi tia trong scan mới nhất (`/scan_filtered`, 720 tia, chỉ nửa trước ±90°):

| Tia | Xóa | Đánh dấu |
|---|---|---|
| Có điểm cuối, ≤ 2.5 m | Các ô từ LiDAR tới trước điểm cuối → FREE | Ô điểm cuối → LETHAL |
| Có điểm cuối, 2.5–3.0 m | Các ô trên đường tia → FREE | Không |
| Có điểm cuối, > 3.0 m | Tia bị cắt ở 3.0 m, xóa tới đó | Không |
| `inf` (không phản hồi) | **Không** (`inf_is_valid: false`) | Không |
| NaN (nửa sau) | Không | Không |

- Xóa chạy **trước** đánh dấu trong cùng chu kỳ. Ô vừa bị tia khác xóa vẫn được đánh dấu lại nếu có điểm cuối
  nằm trong nó.
- `footprint_clearing_enabled: true`: ô nằm trong vòng 0.25 m dưới robot bị xóa. Robot không tự thấy mình là vật cản.
- `combination_method: 1` (max): lớp này chỉ nâng giá trị của master, không hạ.
- LiDAR chỉ quét **một mặt phẳng cao 0.347 m**. Vật thấp hơn hoặc nhô ra phía trên (mặt bàn) không được đánh dấu.

Ví dụ:
- **Người đứng chắn rồi đi khỏi:** chu kỳ kế tiếp các tia trúng tường phía sau đi qua chỗ người đứng → ô bị xóa,
  trong ≤ ~0.3 s.
- **Người đi khỏi nhưng phía sau trống (ngoài 3 m / tia `inf`):** không có tia nào xóa → ô **vẫn LETHAL**. Thường gặp
  ở cửa mở, hành lang dài, kính.
- **Vật đi ra sau lưng:** giữ nguyên tới khi ra khỏi cửa sổ.

#### 6.6.5 Camera: đánh dấu và xóa (`fusion_layer`)

Mỗi frame point cloud (D435, ~15 fps) được biến đổi về `odom` rồi xử lý như sau.

**Bước 1: lọc điểm.** Điểm được dùng để đánh dấu khi thỏa cả:
- cao 0.05–0.70 m so với sàn (thấp hơn = sàn / nhiễu sàn; cao hơn = robot đi lọt dưới);
- cách camera theo phương ngang 0.30–2.5 m;
- cách tâm robot ≥ 0.25 m (bỏ điểm trên thân robot).

Ô 5 cm có ≥ 3 điểm như vậy = "camera thấy ô này trong frame này". Mỗi ô nhớ dải độ cao `[zmin, zmax]` đã thấy.

**Bước 2: trạng thái ô.**

```
           thấy (frame 1)               thấy 3 frame liên tiếp
  (không) ───────────────▶ PENDING ──────────────────────────────▶ CONFIRMED ──▶ vẽ LETHAL
                              │        hoặc: gần điểm LiDAR mới              │
                              │                                             │
                  lỡ 1 frame  ▼                       nhìn xuyên 2 frame    ▼
                           bỏ ngay                    hoặc 10 s không thấy → xóa
```

| Trạng thái | Vẽ vào costmap? | Ra khỏi trạng thái khi |
|---|---|---|
| `PENDING` | Không | 3 frame liên tiếp → `CONFIRMED`; lỡ 1 frame → bỏ |
| `CONFIRMED` | Có (LETHAL) | Nhìn xuyên 2 frame, hết 10 s, hoặc xa robot > 3 m |

- `PENDING` lọc nhiễu độ sâu: một chấm nhiễu xuất hiện 1–2 frame không bao giờ thành vật cản.
- Ô `PENDING` nằm trong 0.10 m quanh một điểm LiDAR (scan ≤ 0.5 s) → `CONFIRMED` **ngay**, không cần đủ 3 frame.

**Bước 3: xóa ("nhìn xuyên qua").** Ảnh độ sâu được gom thành lưới bin 1° (ngang) × 2° (đứng) quanh trục camera.
Mỗi bin giữ khoảng cách ngang nhỏ nhất. Ô `CONFIRMED` không thấy trong frame này được tính là trống khi **mọi** bin
phủ dải `[zmin, zmax]` của ô đều có điểm, và điểm đó **xa hơn** ô (> d + 0.05 m). Nghĩa là camera nhìn thấy
thứ ở phía sau, xuyên qua đúng chỗ vật từng đứng.

Không xóa (chờ hết 10 s) khi:
- bin rỗng: lỗ độ sâu (vật đen, kính, phản quang);
- có vật gần hơn che ô;
- ô ra ngoài góc nhìn ngang ~80° hoặc dải độ cao rơi ra ngoài góc nhìn đứng ~55° (robot quá gần mặt bàn);
- ô gần camera hơn 0.30 m.

**Bước 4: vẽ.** Mỗi chu kỳ costmap, ô `CONFIRMED` được ghi LETHAL vào master, **trừ** ô nằm trong 0.10 m quanh một
điểm LiDAR mới. Ô đó LiDAR đã vẽ, ở vị trí chính xác hơn, nên camera không vẽ chồng (tránh vật "dày" ra).

#### 6.6.6 Camera và LiDAR gộp lại thế nào

Hai lớp giữ bộ nhớ **riêng**. Master lấy **max** của hai lớp, rồi inflation tô quanh mọi ô LETHAL.

| LiDAR | Camera | Ô trên master |
|---|---|---|
| Thấy | Thấy | LETHAL ngay (`obstacle_layer` vẽ) |
| Không | Thấy | LETHAL sau 3 frame (`fusion_layer` vẽ) |
| Thấy | Không | LETHAL (`obstacle_layer` vẽ) |
| Không | Không | FREE, sau khi **cả hai** lớp đã xóa ô |

- Camera nhìn xuyên **không xóa** được vật LiDAR đang nhớ, và ngược lại. Mỗi cảm biến chỉ xóa bộ nhớ của mình.
- Vì vậy một ô chỉ trở lại FREE khi lớp nào đang giữ nó tự xóa: tia LiDAR đi qua, hoặc camera nhìn xuyên / hết 10 s.

Thời gian từ lúc vật xuất hiện tới khi có trong costmap (ước lượng từ tần số, chưa đo trên robot):

| Trường hợp | Trễ |
|---|---|
| LiDAR thấy (scan 10 Hz) | ≤ ~0.3 s |
| Chỉ camera thấy (15 fps × 3 frame) | ~0.35–0.5 s |
| Cả hai thấy | như LiDAR |

#### 6.6.7 Inflation: biến ô LETHAL thành vùng nguy hiểm

Với khoảng cách `d` từ tâm ô tới ô LETHAL gần nhất:

| `d` | Chi phí |
|---|---|
| 0 | 254 LETHAL |
| ≤ 0.25 m | 253 INSCRIBED |
| 0.30 m | ~217 |
| > 0.30 m | 0 |

- Công thức: `252 · exp(−3.0 · (d − 0.25))` cho 0.25 < d ≤ 0.30 (chỉ ~1 vòng ô quanh vùng cấm).
- CustomDWB loại cứng mọi quỹ đạo có ô ≥ 253 (tâm robot cách vật < 0.25 m). Vùng 1–252 chỉ bị phạt mềm (mục 8).
- Trước 2026-10-21: nội tiếp 0.30 m, inflation 0.45 m (0.35 m ~217, 0.40 m ~187, 0.45 m ~160).

#### 6.6.8 Xem bộ nhớ costmap khi chạy

```bash
ros2 topic echo /local_costmap/fusion_layer/status   # pending_cells, confirmed_cells, drawn_cells, cloud_age
ros2 service call /local_costmap/clear_entirely_local_costmap nav2_msgs/srv/ClearEntireCostmap   # xóa hết cả 2 lớp
```
- RViz: `/local_costmap/costmap` (2 Hz). Vật "ma" còn lại sau khi người đi khỏi thường là trường hợp không có tia
  LiDAR nào đi qua (mục 6.6.4).
- `drawn_cells` < `confirmed_cells`: phần chênh là ô LiDAR đã vẽ (`lidar_suppressed_cells`).

#### 6.6.9 Lý do chọn tham số

- **2 × 2 m (không phải 3 × 3):** Nav2 DWB lấy đích cục bộ = điểm cuối đường A\* còn trong costmap. Với 3 × 3 m, ở
  đầu tường đích cục bộ nằm sau tường → robot đứng yên → abort (tái hiện offline).
- **Padding 0.05 m, inflation 0.30 m, `stopping_margin` 0.02 m (2026-10-21, user):** đi sát và qua khe hẹp hơn.
  Mô phỏng: khe 0.58 / 0.64 m từ 0/5 → 5/5 (khe 0.54 m vẫn dừng), né vật cản vẫn 35/35, 0 va chạm, nhưng khoảng hở
  thân nhỏ nhất 0.14 → **0.05 m** (robot trễ 0.7 s: 0.03 m). Trước đó dùng 0.10 / 0.45 / 0.05 vì offline padding 0
  làm DWB chạm vật cản. Quay về an toàn hơn: padding 0.10, inflation 0.45, margin 0.05.
- **Đánh đổi:** DWB vẫn không qua được khe < ~0.55 m, trong khi A\* lập đường qua khe ≥ 0.4 m.
- Nửa sau scan là NaN, mà `track_unknown_space: false` → vùng phía sau được coi là **trống**. Bảo vệ thực sự là
  **không cho lùi**.
- **Giới hạn của `fusion_layer`:** nó không xóa ô dưới thân robot (khác `obstacle_layer`). Một ô ma của camera sát
  robot (< 0.30 m từ camera, không nhìn xuyên được) chỉ mất sau 10 s. Nếu nó nằm trong vùng 0.25 m quanh tâm,
  CustomDWB báo BLOCKED và đứng yên trong lúc đó.

### 6.7 Lớp camera trong `local_costmap` (M2, tùy chọn)

Bật bằng `camera:=true` (hoặc `camera_layer:=fusion|voxel`). Launch nạp thêm một file YAML **sau**
`nav2_params.yaml`, file này ghi đè `plugins` của local costmap.

| `camera_layer` | `plugins` |
|---|---|
| `none` (mặc định khi `camera:=false`) | `obstacle_layer`, `inflation_layer` |
| `fusion` | `obstacle_layer`, `fusion_layer`, `inflation_layer` |
| `voxel` | `obstacle_layer`, `camera_layer` (VoxelLayer), `inflation_layer` |

Tham số chính của `fusion_layer` (`config/camera_fusion.yaml`, đều là giá trị khởi đầu):

| Tham số | Giá trị |
|---|---|
| `cloud_topic` | `/camera/camera/depth/color/points` |
| Dải độ cao vật cản | 0.05–0.70 m |
| Tầm (ngang từ camera) | 0.30–2.5 m |
| `confirm_frames` / `clear_frames` | 3 / 2 |
| `decay_time` | 10 s |
| `lidar_association_radius` | 0.10 m |
| `expected_update_rate` | 1.0 s |

- `max_obstacle_height` 0.70 m = chiều cao robot kể cả laptop (**đo 0.60 m**, 2026-11-03) + 0.1 m lề.
- Không có cloud mới trong 1 s → local costmap "không current" → controller_server ngừng điều khiển → robot dừng.
  Camera chết thì robot dừng chứ không chạy mù.
- Tham số chỉ đọc lúc khởi động (đổi → chạy lại launch).
- Cơ chế lưu nhớ / xóa ô: mục 6.6.2, 6.6.5, 6.6.6. Luật và kết quả offline: mục 9.6.

### 6.8 `goal_path_bridge`

| Tham số | Giá trị | Ý nghĩa |
|---|---|---|
| `global_frame` / `robot_base_frame` | `map` / `base_footprint` | – |
| `planner_id` | `GridBased` | – |
| `tf_timeout` | 0.5 s | TF cũ hơn: cảnh báo (A\*) / từ chối (FollowPath) |
| `controller_id` | `FollowPath` (launch ghi đè `CustomDWB`) | Plugin DWB |
| `goal_checker_id` | `general_goal_checker` | – |
| `auto_follow` | `false` | – |
| `max_path_age` | 30 s | Đường cũ hơn → từ chối |
| `max_start_distance` | 0.5 m | Robot cách đường xa hơn → từ chối |
| `follow_timeout` | 120 s | Quá thời gian → hủy |
| `require_localized` | `true` (launch tính lại) | Đòi LOCALIZED |
| `localization_status_timeout` | 2.0 s | Status cũ hơn → coi như mất |
| `localization_uncertain_grace` | 2.0 s | WARN ngắn hơn được bỏ qua |

Các tham số FollowPath **được đọc lại mỗi lần dùng**, nên `ros2 param set /goal_path_bridge ...` có tác dụng ngay.

---

## 7. `goal_path_bridge`: phân tích chi tiết

### 7.1 Nhận goal (`onGoal`)
1. `frame_id` rỗng thì gán `map`.
2. **Hủy FollowPath đang chạy** (goal mới luôn dừng robot trước) và xóa đường cũ.
3. Chưa nhận `/map` → lỗi `no map on /map`.
4. Không có TF `map → base_footprint` → lỗi (gợi ý đặt 2D Pose Estimate). TF cũ hơn 0.5 s chỉ **cảnh báo**.
5. `planner_server` chưa sẵn sàng → lỗi.
6. Gửi `ComputePathToPose` (`use_start: false`: điểm đầu = pose hiện tại của robot).

Kết quả A\*:
- Thuộc goal cũ (đã có goal mới) → bỏ qua.
- **Thành công** → publish `/global_path`, lưu đường + thời điểm. Nếu `auto_follow` thì bắt đầu bám ngay.
- **Thất bại** → publish đường rỗng (xóa RViz) + log lý do, đọc từ global costmap:

| Thông báo | Nghĩa |
|---|---|
| `Goal is in an obstacle (lethal)` | Đích nằm trên vật cản |
| `Goal is closer than the robot radius ... (inscribed)` | Đích quá sát tường (< 0.20 m) |
| `Goal is in unknown space` | Đích ở vùng chưa quét |
| `Goal is outside the map` | Đích ngoài bản đồ |
| `Both cells are free: goal is probably enclosed ...` | Không có đường nối (bị bao kín, hoặc chỉ qua unknown) |

### 7.2 Bắt đầu bám đường (`startFollow`)
Bridge **từ chối** (state `REFUSED: ...`) theo thứ tự:
1. Đang có FollowPath chạy (gọi `cancel` trước).
2. Chưa có đường A\* hợp lệ.
3. Đường cũ hơn 30 s.
4. Không có TF, hoặc TF cũ hơn 0.5 s.
5. Robot cách đường > 0.5 m (ví dụ đã lái PS4 đi chỗ khác).
6. `require_localized` mà status không có / cũ hơn 2 s / **khác OK**. Lúc bắt đầu, WARN cũng bị từ chối.
7. `/follow_path` chưa sẵn sàng.

Qua hết thì gửi **đúng một** goal FollowPath với đường A\* đã lưu. Đường này không đổi tới khi kết thúc.

### 7.3 Trạng thái trên `/goal_path_bridge/follow_state`

| Trạng thái | Nghĩa |
|---|---|
| `IDLE` | Vừa khởi động |
| `FOLLOW_REQUESTED` | Đã gửi FollowPath, chờ server nhận |
| `FOLLOWING` | DWB đang bám |
| `REFUSED: <lý do>` | `follow` bị từ chối |
| `REJECTED` | controller_server không nhận goal |
| `SUCCEEDED` | Tới đích |
| `CANCELED` / `CANCELED: <lý do>` | Bị hủy (người dùng, goal mới, timeout, localization, tắt node) |
| `ABORTED` | controller_server bỏ cuộc (DWB không có quỹ đạo, không tiến, TF/costmap lỗi) |

### 7.4 Giám sát (timer 200 ms, `watchFollow`, chỉ khi đang bám)
1. **Quá 120 s** từ lúc gửi FollowPath → hủy.
2. **Localization** (khi `require_localized`):
   - `LOST` hoặc status cũ > 2 s → hủy **ngay**;
   - `UNCERTAIN` / `INITIALIZING` liên tục ≤ 2 s → bỏ qua (chỉ log);
   - WARN > 2 s → hủy.

### 7.5 Kết quả FollowPath

| Kết quả | Bridge xử lý |
|---|---|
| SUCCEEDED | `SUCCEEDED` |
| CANCELED | `CANCELED` |
| ABORTED | `ABORTED`. **Không thử lại.** Robot dừng (controller_server phát 0); gửi goal mới để đi tiếp |

### 7.6 Tắt node
Bridge tự bắt Ctrl+C / SIGTERM, gửi cancel FollowPath, chờ 0.5 s cho yêu cầu kịp đi, rồi mới thoát. controller_server
khi bị hủy sẽ phát lệnh 0.

---

## 8. CustomDWB: phân tích chi tiết

### 8.1 Khi nhận đường (`setPlan`)
- Xóa trạng thái theo đường: chốt đích, pha xoay, chiều xoay, chống dao động.
- `frame_id` rỗng, hoặc hướng đích không hợp lệ → lỗi → goal bị abort.
- Gộp các điểm trùng liên tiếp, tính độ dài cung tích lũy, đặt tiến trình = 0.
- Chỉ dùng hướng của **điểm cuối** (NavFn không đặt hướng cho các điểm giữa).

### 8.2 Một chu kỳ (`computeVelocityCommands`, 10 Hz)

**(a) Kiểm tra đầu vào.** Lỗi nào cũng → lệnh 0 + báo lỗi:
- không có đường;
- pose hoặc vận tốc không hữu hạn;
- frame pose khác `odom`;
- TF `odom → base_footprint` cũ hơn 0.5 s;
- `/odometry/filtered` chưa có hoặc im lặng > 0.5 s.

Hai chu kỳ cách nhau > 0.25 s (bị ngắt quãng) → quên lệnh trước, lấy vận tốc đo làm gốc.

**(b) Một TF `map → odom` duy nhất cho cả chu kỳ.**
- Chờ tối đa 0.3 s; tuổi > 1.0 s → lỗi.
- AMCL đóng dấu TF vào **tương lai** (+1 s), nên tuổi âm là bình thường.
- Dùng chung TF này cho đường cục bộ và đích, nên hai thứ luôn khớp nhau.

**(c) Bám tiến trình dọc đường (`PathTracker`).**
- Chỉ tìm hình chiếu trong 1.0 m phía trước tiến trình hiện tại. Lấy **cực tiểu đầu tiên**, nên với đường chữ U /
  tự cắt, robot không nhảy sang nhánh kia.
- **Tiến trình không bao giờ giảm.**
- Lệch đường > 0.8 m → lỗi.
- Đường cục bộ = 1.5 m tiếp theo, chuyển sang `odom`, **cắt ở mép local costmap** (thực tế ~1–1.4 m).

**(d) Dung sai đích:** lấy từ goal checker (0.15 m / 0.25 rad).

**(e) Chọn pha**, theo thứ tự ưu tiên:

```text
             d < 0.135 m                                lệch hướng > 0.8 rad
FOLLOW_PATH ───────────> ROTATE_TO_GOAL     FOLLOW_PATH ─────────────────> ROTATE_TO_PATH
            <───────────                                <─────────────────
             d > 0.20 m, hoặc đúng hướng mà d > 0.135     lệch hướng < 0.4 rad
```

Trước khi chọn pha:
- Ô dưới tâm robot ≥ 253 (cách vật cản < 0.25 m), unknown, hoặc ngoài costmap → `BLOCKED`, lỗi.
- **Robot đứng quá sát vật cản thì không ra lệnh nào, kể cả xoay.** Không lùi được nên không tự thoát.

**Vận tốc gốc** (`velocity_reference: command`):
- Gốc = lệnh trước, kẹp trong ±0.15 m/s và ±0.5 rad/s quanh vận tốc đo.
- Lý do: phản hồi trễ ~0.2–0.7 s. Nếu tính từ vận tốc đo thì gia tốc thực rất nhỏ, gây quay lố ~50° (robot
  2026-10-14).
- Kẹp quanh vận tốc đo để gốc không trôi xa thực tế khi PS4 chiếm quyền hoặc bánh bị kẹt.

**Pha 1: `ROTATE_TO_GOAL`** (ưu tiên cao nhất)
- Vào khi khoảng cách tới đích < 0.135 m (0.9 × 0.15).
- Lệch hướng > 0.225 rad → xoay tại chỗ về hướng đích.
- Đúng hướng và d ≤ 0.135 → giảm (v, ω) về 0, chờ goal checker báo xong.
- Đúng hướng nhưng 0.135 < d ≤ 0.20, hoặc trôi ra > 0.20 m → quay lại tiếp cận.

**Pha 2: `ROTATE_TO_PATH`**
- "Cà rốt" = điểm cách đầu đường cục bộ 0.8 m.
- Hướng tới cà rốt lệch > 2.5 rad (~143°) → xoay tại chỗ, tới khi < 1.25 rad (cũ 0.8 / 0.4). Lệch nhỏ hơn → đi theo cung.
- Ví dụ: đích ở sau lưng → xoay ~180° trước rồi mới đi.

**Cách xoay** (chung cho hai pha xoay):
- Gần ±π: **giữ chiều đã chọn**, để nhiễu không làm robot lật trái/phải.
- `còn lại = |sai số| − phần đã quay do trễ (0.2 s + 0.05 s)`.
- `|ω| = min(1.5 × còn lại, √(2 × 2.0 × còn lại), 1.0)`, tối thiểu 0.1.
- Thực tế: chạy 1.0 rad/s tới khi còn ~0.67 rad thì chậm dần. ω đổi tối đa 0.2 rad/s mỗi chu kỳ (cũ 0.5 rad/s, 0.1).
- v giảm dần về 0 theo `decel_lim_x`.
- Lệnh xoay cũng được **mô phỏng và kiểm tra va chạm** như mọi quỹ đạo khác.

**Pha 3: `FOLLOW_PATH`** (DWA)
1. **Cửa sổ vận tốc:** v ∈ [gốc ± 0.05] ∩ [0, 0.15]; ω ∈ [gốc ± 0.1] ∩ [−0.5, 0.5].
   - Ví dụ: gốc (0.10, 0) → v ∈ [0.05, 0.15], ω ∈ [−0.1, 0.1].
   - Vận tốc đang vượt giới hạn (vừa lái PS4 nhanh) → lệnh = giới hạn gần nhất, cờ `overspeed`.
2. **Lấy mẫu:** 20 × 21 giá trị, luôn thêm v = 0 và ω = 0.
3. **Mô phỏng** mỗi ứng viên, bắt đầu từ vận tốc **đo**:
   - 0 → 0.2 s: lệnh trước vẫn đang tác dụng (trễ);
   - 0.2 → 0.3 s: chuyển sang ứng viên;
   - 0.3 → 1.7 s: giữ ứng viên;
   - **đuôi phanh**: từ 0.3 s phanh về 0, cộng thêm 0.05 m phía trước;
   - bước ≤ 0.05 s và quét ≤ nửa ô (0.025 m), để không lọt ô nào.
4. **Loại cứng:** pose nào (kể cả pose đầu và đuôi phanh) chạm ô ≥ 253, unknown, hoặc ra ngoài costmap → loại.
   Đây là điều kiện "chỉ chọn vận tốc phanh kịp" (Fox 1997).
5. **Chấm điểm mềm** (ứng viên hợp lệ):

| Thành phần | Đo gì | Trọng số |
|---|---|---|
| path | Cuối quỹ đạo cách đường bao xa (m) | 4.0 |
| carrot | Cuối quỹ đạo cách cà rốt bao xa (m) | 2.0 |
| heading | Lệch hướng tới cà rốt ở cuối quỹ đạo, /π | 1.0 |
| obstacle | Cost lớn nhất dọc cung 0.255 m cố định, /252 | 0.5 |
| speed | (0.15 − v) / 0.15 | 0.3 |
| oscillation | 1 nếu đổi chiều xoay ngay sau lần đổi trước | 1.0 |

   Cung obstacle có **độ dài cố định**, không phụ thuộc tốc độ. Nếu đo theo thời gian, ứng viên chậm "thấy" ít vùng
   gần vật cản hơn nên luôn rẻ hơn, và robot bò dần về 0 ở mép vùng đó (lỗi B1 đã sửa).
6. Chọn ứng viên rẻ nhất. Không còn ứng viên nào → `BLOCKED` → lỗi.
7. Có ứng viên nhưng **không cái nào có v > 0** (vật cản ngay trước) → v = 0, cảnh báo `holding position`.

**(f) Hiển thị:** `/local_plan`, `/CustomDWB/local_path`, marker quỹ đạo, `/CustomDWB/state` (5 Hz, và ngay khi đổi
pha hoặc lỗi). Log `phase X -> Y` mỗi khi đổi pha.

### 8.3 controller_server làm gì với lỗi của plugin
- Plugin lỗi → controller_server phát lệnh 0. Lỗi kéo dài > 0.3 s (~3 chu kỳ) → abort FollowPath.
- Progress checker báo lỗi → abort ngay.
- Bị hủy / abort / deactivate → phát lệnh 0.

### 8.4 Sơ đồ luồng một chu kỳ

> **Cách đọc:** từ trên xuống dưới. Sơ đồ chính chỉ mô tả **một chu kỳ quyết định lệnh**; vòng phản hồi ở mục 8.5 để tránh dây nối chồng chéo.

```mermaid
flowchart TB
    subgraph INPUT["① DỮ LIỆU ĐẦU VÀO"]
        direction LR
        A["Đường A*<br/>global path"]
        B["Pose + TF<br/>Odometry"]
        C["Local costmap<br/>LiDAR + Camera nếu bật"]
    end

    B --> SAFE{"② Kiểm tra dữ liệu<br/>còn hợp lệ?"}
    C --> SAFE
    SAFE -->|Không| ERR(["Dừng / báo lỗi"])
    SAFE -->|Có| TRACK["PathTracker<br/>Đường cục bộ 1.5 m<br/>Carrot 0.8 m"]
    A --> TRACK

    TRACK --> MODE{"③ Chọn pha điều khiển"}
    MODE -->|FOLLOW_PATH| DW["Dynamic Window<br/>Giới hạn vận tốc & gia tốc"]
    DW --> SAMPLE["Lấy mẫu ≈ 420 ứng viên<br/>(v, ω)"]
    MODE -->|ROTATE_TO_PATH / GOAL| ROT["Tạo lệnh xoay"]

    SAMPLE --> SIM["④ Mô phỏng quỹ đạo 2 s<br/>Trễ lệnh + đuôi phanh"]
    ROT --> SIM

    SIM --> HIT{"⑤ Kiểm tra costmap<br/>Cost ≥ 253?"}
    HIT -->|Có| DISCARD["Loại ứng viên"]
    HIT -->|Không| SCORE["Chấm điểm quỹ đạo hợp lệ<br/>Path · Carrot · Heading<br/>Obstacle · Speed · Oscillation"]
    DISCARD -.-> NONE["Nếu không còn ứng viên:<br/>BLOCKED / dừng"]

    SCORE --> PICK["⑥ Chọn ứng viên hợp lệ<br/>có tổng chi phí nhỏ nhất"]
    PICK --> OUT["Xuất lệnh vận tốc (v, ω)"]
    OUT --> ENABLE{"navigation_enabled?"}
    ENABLE -->|false| DRY["/cmd_vel_dwb<br/>Chế độ cách ly motor"]
    ENABLE -->|true| DRIVE["/cmd_vel_nav<br/>twist_mux → Driver → Motor"]

    classDef data fill:#eaf3ff,stroke:#377caf,color:#173b5b,stroke-width:1.5px;
    classDef step fill:#e7f6f2,stroke:#25977e,color:#164e44,stroke-width:1.5px;
    classDef decision fill:#fff3d9,stroke:#d39a26,color:#704c0a,stroke-width:1.8px;
    classDef stop fill:#ffe8e6,stroke:#cb5a57,color:#772e2b,stroke-width:1.5px;
    classDef output fill:#e9e8ff,stroke:#796ac7,color:#342b6b,stroke-width:1.5px;

    class A,B,C data;
    class TRACK,DW,SAMPLE,ROT,SIM,SCORE,PICK step;
    class SAFE,MODE,HIT,ENABLE decision;
    class ERR,DISCARD,NONE stop;
    class OUT,DRY,DRIVE output;
    style INPUT fill:#f6f8fa,stroke:#b9c8d4,color:#223b53,stroke-width:1px;
```

### 8.5 Vòng phản hồi điều khiển

```mermaid
flowchart LR
    CMD["CustomDWB<br/>Xuất (v, ω)"] --> MUX["twist_mux<br/>/cmd_vel_out"]
    MUX --> DRIVER["Driver + Motor"]
    DRIVER --> ODOM["Encoder / Odometry<br/>EKF"]
    ODOM --> NEXT["CustomDWB<br/>Chu kỳ kế tiếp 10 Hz"]

    classDef blue fill:#eaf3ff,stroke:#377caf,color:#173b5b,stroke-width:1.5px;
    classDef green fill:#e7f6f2,stroke:#25977e,color:#164e44,stroke-width:1.5px;
    class CMD,NEXT blue;
    class MUX,DRIVER,ODOM green;
```

**Lưu ý:** Sơ đồ phản hồi chỉ áp dụng khi `navigation_enabled:=true` và motor thực sự nhận lệnh. Sơ đồ được giản lược để dễ học: nhánh `ROTATE` cũng phải kiểm tra an toàn, còn nhánh `FOLLOW_PATH` chấm điểm các quỹ đạo sau khi loại ứng viên va chạm. Các thông số 1.5 m, 0.8 m, 2 s và số ứng viên lấy từ README; cần kiểm tra YAML/source hiện chạy nếu đã thay đổi cấu hình.

### 8.6 Vai trò của từng nhóm tham số

| Nhóm trong mục 6.4 | Quyết định điều gì? | Ảnh hưởng trực tiếp tới |
|---|---|---|
| **Giới hạn động học** | Robot được phép tăng tốc, giảm tốc và quay nhanh bao nhiêu | Dynamic Window, phanh |
| **Lấy mẫu và mô phỏng** | Thử bao nhiêu lệnh, dự đoán robot đi đến đâu | Khả năng phát hiện va chạm, tải CPU |
| **Vận tốc gốc** | Dựa vào lệnh trước hay vận tốc đo để tạo các lệnh tiếp theo | Độ mượt, độ trễ, overshoot |
| **Bám đường** | Robot được lệch đường A* bao xa và hướng tới điểm nào | Bám đường và đi vòng vật cản |
| **Pha xoay và đích** | Khi nào xoay tại chỗ, khi nào đi tiếp, khi nào tới đích | Rẽ và hoàn thành goal |
| **Trọng số chi phí** | Trong những quỹ đạo an toàn, ưu tiên quỹ đạo nào | Né vật cản, tốc độ, bám đường |
| **Chống dao động** | Có nên phạt việc liên tục đổi hướng quay không | Hiện tượng lắc trái/phải |
| **An toàn dữ liệu** | Có được tin thông tin cảm biến, TF và odometry không | Dừng an toàn |

### 8.7 Ví dụ: CustomDWB xử lý khi gặp vật cản

#### 8.7.1 Giới hạn động học

Ở tần số điều khiển **10 Hz**, khoảng thời gian mỗi chu kỳ là **0.1 giây**.

Với `acc_lim_theta = 2.0 rad/s²`:

$$
\Delta\omega_{\max}=\alpha_{\max}\Delta t=2.0\times0.1=0.2\ \text{rad/s}
$$

Nghĩa là tốc độ quay được phép thay đổi tối đa **0.2 rad/s** giữa hai lệnh liên tiếp theo giới hạn gia tốc.

#### 8.7.2 Lấy mẫu và mô phỏng

CustomDWB lấy khoảng **420 ứng viên vận tốc** (`vx_samples = 20`, `vtheta_samples = 21`), giả lập mỗi ứng viên trong **2 giây**, có xét trễ lệnh và đuôi phanh.

Ở vận tốc không đổi **0.20 m/s**, quãng đường lý tưởng trong 2 giây là:

$$
s=v\times t=0.20\times2.0=0.40\ \text{m}
$$

Quỹ đạo mô phỏng thực tế còn phụ thuộc gia tốc, tốc độ quay và độ trễ điều khiển.

#### 8.7.3 Loại bỏ va chạm

Nếu một quỹ đạo có tâm robot đi vào ô costmap có giá trị:

- **253 (`INSCRIBED`)**: Vùng quá gần vật cản.
- **254 (`LETHAL`)**: Ô chứa vật cản.

Quỹ đạo đó bị loại, dù có bám sát đường A* đến đâu.

#### 8.7.4 Chấm điểm các quỹ đạo còn lại

Theo trọng số hiện tại trong mục 6.4:

$$
\begin{aligned}
J ={}& 0.5C_{\text{path}} + 2.0C_{\text{carrot}} \\
&+ 0.3C_{\text{heading}} + 4.0C_{\text{obstacle}} \\
&+ 1.5C_{\text{speed}} + 1.0C_{\text{oscillation}}
\end{aligned}
$$

CustomDWB chọn quỹ đạo hợp lệ có **tổng chi phí J nhỏ nhất**.

Với `obstacle_scale = 4.0`, chi phí vùng gần vật cản được nhấn mạnh hơn so với cấu hình cũ.

#### 8.7.5 Phản hồi và chu kỳ tiếp theo

Sau khi chọn được cặp vận tốc `(v, ω)`, lệnh được gửi đến driver khi `navigation_enabled:=true`.

Odometry phản hồi vận tốc đo, và ở chu kỳ tiếp theo, CustomDWB tính lại cửa sổ vận tốc.

$$
\text{Quan sát}\rightarrow\text{Dự đoán}\rightarrow\text{Chọn lệnh}\rightarrow\text{Phản hồi}
$$

### 8.8 Quan hệ quan trọng khi tuning

| Thay đổi | Ảnh hưởng dây chuyền |
|---|---|
| `max_vel_x` tăng | Robot đi nhanh hơn → cần xem lại `sim_time`, trễ điều khiển và quãng phanh |
| `acc_lim_theta` tăng | Cửa sổ quay rộng hơn → có thể tìm quỹ đạo rẽ tốt hơn, nhưng phải phù hợp gia tốc thật |
| `sim_time` tăng | Nhìn xa hơn → tăng lượng mô phỏng và khả năng loại bỏ quỹ đạo không an toàn |
| `obstacle_scale` tăng | Ưu tiên tránh vùng nguy hiểm hơn → có thể đứng im nếu `speed_scale` không cân đối |
| `path_distance_scale` giảm | Robot sẵn sàng lệch đường A* để né vật cản → có nguy cơ đi vòng xa |
| `control_latency` sai thực tế | Quỹ đạo dự đoán khác chuyển động thật → nguy cơ phanh muộn hoặc quay lố |
| `footprint_padding` giảm | Dễ qua khe hẹp hơn → giảm biên an toàn vật lý |

---

## 9. DWB tự né vật cản

A\* không biết vật cản mới, nên **việc né vật cản hoàn toàn do CustomDWB làm**, dựa trên local costmap (LiDAR,
2 × 2 m quanh robot, chỉ phía trước ±90°).

### 9.1 Cơ chế
1. **Loại cứng:** quỹ đạo nào (kể cả đuôi phanh) chạm vùng cách vật cản < 0.25 m thì bị loại. Robot không bao giờ
   chọn vận tốc mà không kịp phanh.
2. **Chấm điểm mềm:**
   - quỹ đạo đi gần vùng inflation (≤ 0.30 m quanh vật cản) bị phạt (`obstacle_scale` 4.0);
   - quỹ đạo lệch khỏi đường A\* bị phạt nhẹ (`path_distance_scale` 0.5), cà rốt kéo về đích (`carrot_distance_scale` 2.0);
   - đứng yên / đi chậm bị phạt (`speed_scale` 1.5).
3. Từ 2026-10-21 trọng số **ưu tiên né hơn bám đường** (trước: bám đường 4.0 ≫ vật cản 0.5).

### 9.2 Tuning 2026-10-21 (mô phỏng, chưa thử trên robot)
Ba nguyên nhân khiến bộ cũ **không bao giờ né** (tìm bằng mô phỏng kín vòng lõi DWA):

| Nguyên nhân | Sửa |
|---|---|
| Cửa sổ ω chỉ ±0.1 rad/s/chu kỳ → mọi ứng viên có cùng chi phí vật cản | `acc/decel_lim_theta` 2.0 |
| Đang vòng né, lệch hướng cà rốt > 0.8 rad → xoay tại chỗ quay lại vật cản | `rotate_to_heading_angle` 2.5, cà rốt 0.8 m |
| Bám đường 4.0 ≫ vật cản 0.5; đứng yên không bị tính chi phí vật cản | path 0.5, obstacle 4.0, speed 1.5 |

Kết quả (7 kịch bản vật cản chắn đường × 5 seed, robot trễ 0.2 s):
- bộ cũ: 0/35 né được (dừng → abort); chỉ tăng tốc 0.3 / 1.0: vẫn 0/35;
- bộ mới: 35/35 (robot quay chậm hơn giả định: 35/35; robot trễ 0.7 s: 27/35);
- 0 va chạm, khoảng hở thân ≥ 0.14 m (robot trễ 0.7 s: ≥ 0.09 m); kịch bản thường vẫn 100 %.
- Sau khi giảm padding 0.05 / inflation 0.30 / margin 0.02 (cùng ngày): né vẫn 35/35 (trễ 0.7 s: 28/35), khoảng hở
  thân ≥ 0.05 m (trễ 0.7 s: ≥ 0.03 m).

Đánh đổi:
- robot lệch đường A\* nhiều hơn (vòng né tới ~0.8 m; khúc cua 135° đi theo cung lệch ~0.5 m thay vì xoay tại chỗ);
- tường chắn hẳn: robot men theo tường ~1 m rồi abort `robot too far from the plan` (vẫn không chạm);
- ở 0.2 m/s cần `sim_time` 3.0 (cùng trọng số, 0.2 m/s + 2.0 s chỉ né 21/35).
- Mô phỏng thấy mọi vật cản (không che khuất, không nhiễu LiDAR); gia tốc góc thật của robot chưa đo.

### 9.3 Né được và không né được

| Trường hợp | Hành vi |
|---|---|
| Vật cản **cạnh đường**, còn đủ lối (tâm robot cách vật ≥ 0.25 m) | Lệch nhẹ để giữ khoảng cách, rồi quay về đường. Offline: 5/5 thành công, khoảng hở thân ≥ 0.16 m |
| Vật cản **chắn đường**, nhỏ/vừa, bên cạnh còn lối ≥ ~0.55 m | Từ 2026-10-21: vòng qua rồi về đường (mô phỏng; chưa thử trên robot) |
| Vật cản **chắn hẳn đường** (tường, không còn lối) | Giảm tốc, có thể men theo một đoạn, rồi `Failed to make progress` / `robot too far from the plan` → `ABORTED` |
| Vật cản **di chuyển cắt ngang** | Dừng hoặc giảm tốc khi nó vào vùng nguy hiểm, đi tiếp khi nó qua (chưa thử trên robot) |
| Vật cản **phía sau / bên hông ngoài ±90°** | Không thấy (nửa sau scan bị lọc). Không ảnh hưởng vì robot không lùi |

Trước 2026-10-21 DWB **không đi vòng được** (nhìn trước 0.26 m, bị kéo mạnh về đường A\*). Bộ mới đi vòng được vật cản
nhỏ/vừa (≤ ~0.4 m) khi bên cạnh còn lối ≥ ~0.55 m; vật cản rộng hoặc tường chắn hẳn vẫn dừng → abort.

Sau `ABORTED`: dọn vật cản rồi gửi lại 2D Goal Pose. A\* chỉ biết bản đồ tĩnh nên sẽ cho lại đường cũ.

### 9.4 Tham số ảnh hưởng tới khả năng né

#### 9.4.1 Giới hạn động học

| Tham số | Mức độ | Vùng tốt |
|---|---|---|
| `acc_lim_theta` | nhiều | 2.0 – 3.0 |
| `max_vel_x` | trung bình | 0.15 – 0.3 |
| `max_vel_theta` | trung bình | 0.7 – 1.5 |
| `decel_lim_x` | trung bình | 0.5 – phanh thật |
| `decel_lim_theta` | trung bình | 2.0 – 3.0 |
| `acc_lim_x` | ít | 0.5 (≤ thật) |
| `min_vel_x` | không | 0.0 |
| `min_in_place_vel_theta` | không | 0.1 |

#### 9.4.2 Lấy mẫu và mô phỏng

| Tham số | Mức độ | Vùng tốt |
|---|---|---|
| `sim_time` | nhiều | 2.0 – 3.0 |
| `control_latency` | trung bình | = trễ thật |
| `vx_samples` | ít | 5 – 20 |
| `vtheta_samples` | ít | 11 – 21 |
| `sim_granularity` | ít | 0.05 |
| `stopping_margin` | ít | 0.02 – 0.05 |

#### 9.4.3 Vận tốc gốc của cửa sổ

| Tham số | Mức độ | Vùng tốt |
|---|---|---|
| `velocity_reference` | nhiều | `command` |
| `max_feedback_gap_x` | trung bình | 0.15 – 0.3 |
| `max_feedback_gap_theta` | trung bình | 0.5 – 1.0 |

#### 9.4.4 Bám đường

| Tham số | Mức độ | Vùng tốt |
|---|---|---|
| `max_path_deviation` | nhiều | ≥ 1.0 |
| `carrot_distance` | ít | 0.4 – 0.8 |
| `local_plan_length` | không | 1.5 |
| `closest_search_distance` | không | 1.0 |

#### 9.4.5 Pha xoay và đích

| Tham số | Mức độ | Vùng tốt |
|---|---|---|
| `rotate_to_heading_angle` | nhiều | 2.5 – 3.1 |
| `rotate_gain` | không | 1.5 |
| `xy_goal_tolerance` | không | 0.15 |
| `yaw_goal_tolerance` | không | 0.25 |
| `goal_tolerance_fraction` | không | 0.9 |
| `goal_latch_release_margin` | không | 0.05 |

#### 9.4.6 Trọng số chi phí

| Tham số | Mức độ | Vùng tốt |
|---|---|---|
| `speed_scale` | nhiều | 1.5 – 3.0 |
| `path_distance_scale` | nhiều | 0 – 0.5 |
| `heading_scale` | nhiều | 0 – 0.3 |
| `obstacle_scale` | trung bình | 4.0 – 8.0 |
| `carrot_distance_scale` | trung bình | 2.0 |
| `oscillation_scale` | không | 1.0 |

#### 9.4.7 Chống dao động

| Tham số | Mức độ | Vùng tốt |
|---|---|---|
| `oscillation_reset_dist` | không | 0.05 |
| `oscillation_reset_angle` | không | 0.2 |
| `oscillation_reset_time` | không | 2.0 |

#### 9.4.8 An toàn dữ liệu

| Tham số | Mức độ | Vùng tốt |
|---|---|---|
| `transform_tolerance` | không | 0.3 |
| `max_tf_age` | không | 1.0 |
| `max_pose_age` | không | 0.5 |
| `odom_timeout` | không | 0.5 |
| `collision_check` | không | `auto` |
| `unknown_is_obstacle` | không | `true` |

### 9.5 Cách thử né vật cản trên robot
Trước 2026-10-20: vật cản lớn ngay trước robot làm `localization_monitor` tụt điểm khớp scan–bản đồ → UNCERTAIN →
bridge **hủy sau 2 s, trước khi DWB kịp xử lý** (mục 12). Từ 2026-10-20 monitor có **distance filter** (bỏ tia ngắn hơn
bản đồ; xem `stage2_slam/README.md` mục 7), nên có thể thử **giữ `monitor:=true`** (chưa kiểm chứng trên robot):

```bash
ros2 launch stage3_navigation navigation.launch.py camera:=true csm:=true monitor:=true \
  navigation_enabled:=true auto_follow:=false
ros2 topic echo /localization/status   # xem scan_consistency, scan_consistency_all, blocked_ratio
```

Nếu vẫn bị hủy vì localization, dùng `monitor:=false`. Cách này tắt luôn việc tự hủy khi mất định vị thật, nên
**phải có người giám sát và E-stop**.

### 9.6 Vật cản LiDAR không thấy: lớp camera (M2)

LiDAR chỉ quét một mặt phẳng cao 0.347 m. Nó không thấy mặt bàn, mặt ghế, vật thấp dưới 0.35 m, chân đế ghế xoay.
`FusionLayer` thêm vật cản do camera độ sâu D435 thấy vào local costmap. CustomDWB né chúng như né vật LiDAR thấy.

Luật hợp nhất:

| LiDAR | Camera | Kết quả |
|---|---|---|
| Thấy | Thấy | Vật cản ngay; vẽ theo vị trí LiDAR |
| Không | Thấy | Vật cản sau 3 frame liên tiếp |
| Thấy | Không | Vật cản (do `obstacle_layer` vẽ) |
| Không | Không | Trống, được xóa |

Cách làm:
- `obstacle_layer` (LiDAR) giữ nguyên. `fusion_layer` chỉ giữ bằng chứng của camera. Hai lớp gộp bằng `max`, nên
  camera không bao giờ xóa vật LiDAR thấy.
- Ô camera nằm trong 0.10 m quanh một điểm LiDAR mới được xác nhận ngay nhưng **không vẽ**: LiDAR đã vẽ vật đó,
  ở vị trí chính xác hơn.
- **Xóa ô** chỉ khi camera nhìn xuyên qua ô ở mọi độ cao từng thấy vật, 2 frame liên tiếp. Không xóa khi:
  - có lỗ độ sâu (vật đen, trong suốt);
  - ô bị vật gần hơn che;
  - vật ra khỏi góc nhìn đứng (robot quá gần mặt bàn);
  - ô ra khỏi góc nhìn ngang.
  Các ô đó hết hạn sau `decay_time` 10 s không thấy lại.
- Trạng thái: `ros2 topic echo /local_costmap/fusion_layer/status` (số ô, thời gian xử lý, tuổi cloud).

Kết quả offline lúc phát triển (2026-10-20, camera giả lập, CustomDWB, 3 lần mỗi ô; công cụ benchmark nay đã xoá):

| Kịch bản (CustomDWB, 3 lần) | `none` (chỉ LiDAR) | `fusion` |
|---|---|---|
| Mặt bàn 0.45–0.75 m trên đường | **3/3 đâm** | 3/3 dừng, hở 0.10 m |
| Hộp thấp 0.12 m trên đường | **3/3 đâm** | 3/3 dừng, hở 0.10 m |
| Hộp cao 0.8 m (cả hai thấy) | 3/3 dừng | 3/3 dừng |
| Hộp thấp cạnh đường | 3/3 tới đích | 3/3 tới đích, hở 0.16 m |
| `straight`, `obstacle_near_path` | 6/6 | 6/6 (không vật cản ma) |

- `voxel` (đối chứng): cùng kết quả như `fusion` trên các kịch bản này (camera giả lập không nhiễu, nên chưa thấy
  khác biệt về lọc nhiễu).
- Thời gian tính CustomDWB p99 ~3 ms ở cả ba cấu hình; chu kỳ lệnh p99 ~102 ms (10 Hz giữ được).
- "Dừng" = `holding position` rồi progress checker abort sau 10 s (hành vi đã biết, P4 sẽ xử lý đi vòng).

Chạy trên robot (**thiết bị thật**, hỏi trước; lần đầu cách ly motor):
```bash
ros2 launch stage3_navigation navigation.launch.py camera:=true     # fusion; ảnh camera + point cloud hiện trong planning.rviz
ros2 launch stage3_navigation navigation.launch.py camera:=true camera_layer:=voxel   # đối chứng
```

---

## 10. Các tình huống và cách hệ thống phản ứng

| Tình huống | Diễn biến |
|---|---|
| **Bình thường, đích phía trước** | FOLLOW_PATH, v tăng 0.05 m/s mỗi chu kỳ tới 0.15. Gần đích: ROTATE_TO_GOAL → đúng hướng → dừng → `SUCCEEDED` |
| **Đích ở sau lưng** | ROTATE_TO_PATH ~180° (~3–4 s ở 1.0 rad/s) → FOLLOW_PATH. Xoay > 10 s → `Failed to make progress` |
| **Chế độ cách ly (C)** | Robot không chạy → sau 10 s `Failed to make progress` → `ABORTED`. Bình thường |
| **Vật cản cạnh đường** | Lệch nhẹ né rồi về đường (mục 9) |
| **Vật cản chắn hẳn đường** | Dừng, chờ 10 s → `ABORTED` nếu không thông. Không đi vòng |
| **Vật cản lớn ngay trước (gần)** | Trước 2026-10-20: monitor báo UNCERTAIN → bridge hủy sau 2 s. Nay distance filter bỏ các tia trên vật (chỉ UNCERTAIN khi > 85% tia bị che). Chưa thử trên robot |
| **Robot đứng sát tường / vật cản (< 0.25 m)** | `robot pose is in collision` → lệnh 0 → sau 0.3 s `ABORTED`. Cần lái PS4 ra |
| **Khe hẹp 0.4–0.55 m** | A\* đi qua được, DWB không (nội tiếp 0.25 m) → dừng trước khe → `ABORTED` |
| **Giữ deadman PS4** | twist_mux lấy lệnh PS4. DWB vẫn tính (gốc kẹp quanh vận tốc đo). Lệch > 0.8 m → abort. Thả tay: 0.5 s sau DWB lái tiếp |
| **Gửi goal mới khi đang chạy** | Hủy FollowPath → lệnh 0 → A\* mới → phải gọi `follow` lại (trừ `auto_follow`) |
| **EKF / odom chết** | > 0.5 s: CustomDWB lỗi → lệnh 0 → sau 0.3 s `ABORTED` |
| **AMCL ngừng** | TF `map → odom` cũ quá ~2 s → lỗi. Monitor stale/LOST → bridge hủy |
| **LiDAR đứng** | Local costmap không current → controller_server **treo** (không phát gì, không nhận cancel). Robot dừng nhờ timeout twist_mux 0.5 s / watchdog driver |
| **Localization chập chờn khi quay / đi** | WARN ≤ 2 s bỏ qua; > 2 s hủy. Sau hủy, robot đứng → AMCL không cập nhật → monitor có thể kẹt UNCERTAIN → mọi `follow` bị từ chối. Gỡ: đặt lại 2D Pose Estimate hoặc nhích bằng PS4 |
| **Vượt quá đích > 0.20 m** | Tiến trình kẹt ở cuối đường → cà rốt = đích phía sau → ROTATE_TO_PATH quay lại → tiếp cận lại |
| **Bị đẩy lệch đường** | ≤ 0.8 m: tự kéo về. > 0.8 m: `ABORTED` → gửi goal mới |
| **Đường chữ U / tự cắt** | Không nhảy nhánh nhờ cửa sổ tìm 1 m + cực tiểu đầu tiên |
| **Đổi tham số khi chạy** | Kiểm tra cả lô; sai → giữ cũ; đúng → áp dụng từ chu kỳ sau |
| **IMU mất dữ liệu** | Yaw EKF đứng yên khi robot quay. ROTATE_TO_PATH quay ở 0.5 rad/s không giảm (robot 2026-10-20: ~270°) → sau 10 s `Failed to make progress`. Trong RViz scan xoay lệch bản đồ, monitor LOST. Không có cảnh báo riêng |
| **CSM `AMBIGUOUS`** | AMCL nhận covariance rộng → monitor UNCERTAIN (std_xy > 0.25) → `REFUSED`. Nhích robot cho AMCL hội tụ |

---

## 11. Thời gian truyền và phản hồi

Nhịp lấy từ code và `config/nav2_params.yaml`. Thời gian là **ước lượng**, **chưa đo trên robot** (trừ A\* và
`control_latency`). Các phần trước đó: stage0 (lệnh → motor) `stage0_ps4_control/README.md` mục 5, stage1
(odometry) `stage1_odom/README.md` mục 7, stage2 (LiDAR, AMCL, monitor) `stage2_slam/README.md` mục 8.

**Goal → đường A\***:

| Giai đoạn | Thời gian |
|---|---|
| Bridge kiểm tra `/map`, TF (`tf_timeout` 0.5 s) | ≤ vài ms |
| A\* (log robot, 204 lần) | trung vị 2.3 ms, tối đa 8.8 ms |
| **Có `/global_path`** | **≤ ~20 ms** |

**`follow` → lệnh đầu tiên**:

| Giai đoạn | Thời gian |
|---|---|
| Gửi FollowPath, `controller_server` nhận | ≤ vài ms (chờ server tối đa 2 s) |
| Chờ chu kỳ controller kế tiếp (10 Hz) | ≤ 100 ms |
| **Lệnh đầu trên `/cmd_vel_dwb` / `/cmd_vel_nav`** | **≤ ~0.1 s** |

**Một vòng điều khiển (chỉ khi `navigation_enabled:=true`)**, tối đa:

| Giai đoạn | Thời gian |
|---|---|
| Chu kỳ CustomDWB (10 Hz) | 100 ms |
| Tính toán (offline p99) | ~3 ms |
| `twist_mux` → driver (stage0) | ≤ ~50 ms |
| Driver tăng/giảm tốc (`accel/decel_time_ms`) | ≤ 500 ms |
| Bánh → `/odometry/filtered` (stage1) | ~0.12 s, vận tốc 63 % ~0.34 s |

- `control_latency` 0.2 s đo trên robot (bag `~/rot_debug`, 2026-10-14, khi driver tăng tốc **200 ms**). Driver nay
  500 ms → trễ thật có thể > 0.2 s; mô phỏng của CustomDWB khi đó lạc quan hơn thực tế (mục 6.4, mục 15).
- `velocity_reference: command` giúp lệnh kế tiếp không chờ odometry trễ (mục 8.2).

**Vật cản mới xuất hiện → robot bắt đầu phanh**, tối đa:

| Giai đoạn | Thời gian |
|---|---|
| LiDAR → `/scan_filtered` (stage2) | ≤ ~0.1 s |
| `local_costmap` cập nhật (5 Hz) | ≤ 200 ms |
| Chu kỳ CustomDWB kế tiếp | ≤ 100 ms |
| `twist_mux` → driver | ≤ ~50 ms |
| **Bắt đầu phanh** | **≤ ~0.45 s** |
| Driver giảm tốc về 0 | ≤ 500 ms |

- Ở 0.3 m/s, robot đi thêm ~0.14 m trước khi phanh và ~0.08 m trong lúc phanh (≈ 0.2 m tổng).
- Chỉ camera thấy (M2): cộng thêm ~0.2 s (3 frame ở 15 fps), xem mục 6.6.6.
- CustomDWB chỉ chọn quỹ đạo có đuôi phanh không chạm ô INSCRIBED, nên phần lớn trường hợp né trước chứ không phanh
  gấp. Quãng phanh thật **chưa đo**.

**Dừng / hủy**:

| Nguyên nhân | Tới khi lệnh 0 |
|---|---|
| `/goal_path_bridge/cancel`, goal mới, Ctrl+C | ≤ ~0.1 s (+ 0.5 s ramp driver) |
| Monitor `LOST` / status cũ > 2 s | ≤ 0.2 s sau khi bridge thấy (timer 200 ms) |
| Monitor WARN liên tục | sau 2 s (`localization_uncertain_grace`) + ≤ 0.2 s |
| `/odometry/filtered` im > 0.5 s | lệnh 0 ngay, `ABORTED` sau 0.3 s (`failure_tolerance`) |
| TF quá cũ (`max_pose_age` 0.5 s / `max_tf_age` 1 s) | lệnh 0 ngay, `ABORTED` sau 0.3 s |
| Không tiến được (`SimpleProgressChecker`) | `ABORTED` sau 10 s |
| `follow_timeout` | hủy sau 120 s |
| LiDAR đứng (costmap không current) | `controller_server` không phát gì → dừng nhờ timeout `twist_mux` 0.5 s / watchdog driver 0.5 s |

- Cộng thêm phần monitor phát hiện (stage2 mục 8): ví dụ mất định vị theo consistency cần ≥ 2.5 s mới `LOST`, nên
  từ lúc lạc thật tới lúc robot dừng có thể ~3 s.
- PS4: giữ deadman → `twist_mux` chuyển sang PS4 ngay (≤ ~2 ms); thả ra → DWB lái lại sau 0.5 s (timeout PS4).
- Đo trên robot (kê bánh, E-stop): `ros2 bag record -o ~/nav_lag /cmd_vel_nav /cmd_vel_out /wheel_feedback
  /odometry/filtered /scan_filtered /local_costmap/costmap /CustomDWB/state /goal_path_bridge/follow_state
  /localization/status`, so thời điểm `/cmd_vel_nav` đổi với `/cmd_vel_out`, `/wheel_feedback`,
  `/odometry/filtered`, và lúc vật cản hiện trong `/local_costmap/costmap`.

---

## 12. Kết quả trên robot

Lấy từ log `~/.ros/log/goal_path_bridge_*.log` (không có bag, trừ `~/rot_debug`).

| Ngày | Chạy gì | Kết quả |
|---|---|---|
| 2026-10-13 | `planning.launch.py` | A\* chạy trên `maps/map.yaml` (4.04 m, 7.63 m), hiện trên RViz |
| 2026-10-14 14:58 | `navigation_enabled:=true` | Quay 135° bị lố ~50° → `Failed to make progress`. Đã sửa (`velocity_reference: command`, driver 200 ms) |
| 2026-10-14 15:26 | sau khi sửa (bag `~/rot_debug`) | Không còn quay lố; trễ lệnh → odom ~0.2 s; 2 đích tới nơi; 6/8 lần bị hủy do UNCERTAIN ngắn → thêm grace 2 s |
| 2026-10-14 15:40 | grace 2 s, `control_latency` 0.2 | 2 đích ngắn (1.37 m, 1.28 m) tới nơi. Đích dài 8.82 m: đi ~3.5 m rồi bị hủy (UNCERTAIN > 2 s) |
| 2026-10-16 18:30 | có replan | Đích 1.41 m tới nơi; đích 3.41 m bị hủy (UNCERTAIN); 2 lần abort |
| 2026-10-17 15:58 | có replan, vật cản trên đường | Xoay 180° → đi ~0.3 m → bị hủy (UNCERTAIN, consistency 0.248). Không phải DWB dừng |
| 2026-10-19 08:35–08:48 | có replan | Đích 1.26 m tới nơi; các đích 2.17 m và 5.60 m bị hủy (UNCERTAIN > 2 s); 1 lần bị từ chối lúc bắt đầu |
| 2026-10-20 13:56–14:09 | không replan, `camera:=true` (fusion) | **IMU không gửi dữ liệu** (sau khi cắm lại ESP32): 2 lần quay tại chỗ ~270° → abort; 1 lần quay ~110° → monitor LOST → hủy |
| 2026-10-20 14:17–14:24 | như trên, IMU đã chạy lại | Đích 2.57 m và 1.84 m **tới nơi**. 3 lần abort sau `holding position` (vật cản phía trước, 399/420 quỹ đạo bị loại); 5 lần `REFUSED` (UNCERTAIN do covariance AMCL rộng sau CSM `AMBIGUOUS`) |

**Kết luận:**
- Đích ngắn (~1.3–1.4 m, có xoay tại chỗ) **thường tới nơi**.
- Nguyên nhân dừng giữa đường **chủ yếu là bridge hủy vì monitor báo UNCERTAIN**, không phải DWB.
- Hành vi né vật cản của DWB **chưa được thử trọn vẹn trên robot**, vì các lần có vật cản đều bị hủy vì localization
  trước.
- Các lần chạy 2026-10-14 lúc 15:26 và 15:40 dùng code CustomDWB như hiện tại (`a7c59a1`, cổng cũ). Các lần từ
  2026-10-16 tới 2026-10-19 dùng bản **có replan**. Ngày 2026-10-20 chạy bản hiện tại (không replan, có camera).
- 2026-10-20: lần đầu thấy CustomDWB **dừng trước vật cản** trên robot (`holding position` → abort), nhưng không có
  bag nên chưa biết vật cản thật hay do LiDAR / camera (vật cản ma). Lần sau cần ghi bag (mục 13).

---

## 13. Theo dõi và debug

```bash
ros2 topic echo /goal_path_bridge/follow_state            # trạng thái bám đường
ros2 topic echo /CustomDWB/state --field message          # pha + lỗi của DWB
ros2 topic echo /CustomDWB/state                          # đủ: v/w lệnh, đo, gốc, cost, số reject
ros2 topic echo /localization/status --field message
ros2 topic echo /cmd_vel_dwb                              # chế độ cách ly
grep -E "path found|FollowPath|canceled" ~/.ros/log/goal_path_bridge_*.log   # log lần chạy cũ
```

Các trường hữu ích trong `/CustomDWB/state`:

| Trường | Ý nghĩa |
|---|---|
| `phase` | IDLE / FOLLOW_PATH / ROTATE_TO_PATH / ROTATE_TO_GOAL / BLOCKED |
| `v_cmd`, `w_cmd` | Lệnh vừa phát |
| `v_meas`, `w_meas` | Vận tốc đo |
| `v_ref`, `w_ref` | Gốc của cửa sổ |
| `dist_to_goal`, `progress`, `deviation` | Tiến độ bám đường |
| `n_valid`, `n_forward_valid` | Số ứng viên hợp lệ / hợp lệ mà có tiến |
| `rej_collision`, `rej_braking`, `rej_off_costmap` | Lý do loại |
| `compute_ms`, `over_budget`, `missed_deadline` | Tải tính toán |

Trong RViz (`planning.rviz`):
- **Bật sẵn:** `/map`, `/global_costmap/costmap`, `/scan_filtered`, `/amcl_pose`, `/global_path`,
  `/local_costmap/costmap`, `/local_plan`, `/CustomDWB/trajectories`.
- **Tắt sẵn:** `/marker` (Nav2 DWB), `/CustomDWB/local_path`.
- Màu marker: xanh lá = hợp lệ, đỏ = bị loại, xanh dương = được chọn, cam = đuôi phanh, cầu vàng = cà rốt.

Ghi bag cho lần thử né vật cản (để biết DWB dừng hay bridge hủy):

```bash
ros2 bag record -o ~/obstacle_run /cmd_vel_out /cmd_vel_nav /odometry/filtered /scan_filtered \
  /local_costmap/costmap /CustomDWB/state /goal_path_bridge/follow_state /localization/status /amcl_pose
```

---

## 14. Test

Đã xoá toàn bộ test, mô phỏng và benchmark offline (2026-10-20); package chỉ còn phần chạy trên robot.
`colcon test` chỉ còn chạy linter (ament_lint_auto).

---

## 15. Giới hạn đã biết

- **DWB chỉ né được vật cản không chắn hẳn đường.** Vật cản chắn đường → dừng → abort sau 10 s. Không đi vòng.
- **A\* không biết vật cản mới:** global costmap chỉ có bản đồ tĩnh.
- **Vật cản chưa có trong bản đồ làm monitor tưởng mất định vị** → bridge hủy trước khi DWB xử lý. Đã thêm distance
  filter (2026-10-20, `stage2_slam/README.md` mục 7), **chưa đánh giá trên robot**.
- **Đường dài bị hủy giữa chừng:** điểm khớp scan–bản đồ tụt dần khi đi xa (đích 8.82 m bị hủy sau ~3.5 m).
  Nguyên nhân chưa rõ, cần bag.
- **Không có hành vi phục hồi:** không lùi, không xoay thoát khi đứng sát vật cản.
- **Global vs local khác nhau:** A\* (nội tiếp 0.20 m) đi được khe mà DWB (0.25 m) không qua được.
- **controller_server treo khi scan đứng** (giới hạn của Nav2 Humble): không gọi controller, không publish gì; robot chỉ dừng nhờ timeout 0.5 s của twist_mux / watchdog driver.
- **Feedback `distance_to_goal`** mà bridge log không phản ánh tiến độ. Xem `progress` / `dist_to_goal` trong
  `/CustomDWB/state`.
- **Kiểm tra va chạm chỉ ở ô tâm:** đúng khi footprint tròn và tâm xoay trùng tâm thân (giả định, chưa kiểm chứng).
- **`/local_plan` có hai publisher** (hai plugin); chỉ plugin đang chạy publish.
- **Chưa đo trên robot:** giới hạn vận tốc/gia tốc, quãng phanh, trọng số. `control_latency` 0.2 s mới đo từ một bag.
- **Lớp camera (M2) đã chạy trên robot nhưng chưa đánh giá** (2026-10-20, không bag): độ nghiêng camera (CAD = nằm ngang), vật cản ma từ sàn, chiều cao
  robot kể cả laptop đã đo 0.60 m (2026-11-03, `max_obstacle_height` 0.70 = 0.60 + lề 0.1) nhưng dải độ cao chưa kiểm trên robot. Vật quá gần camera (< 0.3 m, hoặc
  mặt bàn khi robot ở < ~0.8 m) không xóa được, chỉ hết hạn sau 10 s.
- **Mất IMU không bị phát hiện:** `imu_odom`, EKF và CustomDWB đều không báo; chỉ thấy qua `ros2 topic hz /imu_odom`.
- **Driver tăng/giảm tốc 500 ms** (mặc định lại từ 2026-10-19) khác giả định `control_latency` 0.2 s → có thể quay lố.
- **Không có PS4 lock / E-stop phần mềm:** PS4 chỉ ghi đè tạm thời. Dừng thật: `cancel`, Ctrl+C, E-stop phần cứng.
