ppthanh2810/capstone_project/stage3_navigation/doc/audit.md

# Audit CustomDWB — phát hiện → vị trí → test tái hiện → sửa

Cơ sở: báo cáo nghiên cứu (GitHub commit `e6561b4`, "3rd dwb"). Checkout cục bộ ngày 2026-10-14: HEAD =
`e6561b4`; `stage3_navigation/src/dwb_controller.cpp`, `.hpp`, `nav2_params.yaml` **không có thay đổi chưa commit**
(chỉ `launch/*.launch.py` đổi cổng serial — không thuộc phạm vi, giữ nguyên). Mọi phát hiện dưới đây được kiểm lại
trên mã cục bộ trước khi sửa. "Trước" = mã `e6561b4`; "Sau" = mã hiện tại.

## Phát hiện từ báo cáo

| # | Ưu tiên | Phát hiện (đã xác minh) | Vị trí trước | Test tái hiện / chứng minh | Sửa (sau) |
|---|---|---|---|---|---|
| A1 | P0 | Pha xoay chỉ kiểm ô tâm hiện tại rồi trả `v = max(0, v0 − decel·dt)` > 0 | `rotateInPlace()` | `Rotation.ResidualForwardSpeedIsCollisionChecked`: v0 = 0.15, ô INSCRIBED từ 0.05 m phía trước → trước: v = 0.10 được trả; sau: từ chối (`ROTATE_TO_PATH ... rejected`) | `DwaCore::rotate()` mô phỏng trễ + một chu kỳ + đuôi phanh của lệnh (v, ω) thật, cùng kiểm tra cứng như FOLLOW_PATH |
| A2 | P0 | Không có kiểm tra khả năng dừng; ứng viên (v, ω) được coi là đạt tức thì và giữ hằng | `simulate()`, `scoreTrajectory()` | `Braking.RejectsVelocityThatCannotStopEvenIfHorizonIsFree` (chân trời 0.2 s trống, cần ~0.2 m để dừng → `BRAKING`); `Braking.StoppingDistanceGrowsWithLatency` (d = v(τ+dt) + v²/2a + margin) | `rolloutCommand()`: [0, τ) theo lệnh trước → chuyển tiếp có giới hạn gia tốc → giữ; đuôi phanh từ τ + dt; `control_latency` (0.1 s, **synthetic**), `stopping_margin` (0.05 m) |
| A3 | P0 | Cửa sổ rỗng bị ép về `max_vel` và coi như đạt được | `searchDynamicWindow()` dòng `if (v_lo > v_hi)` | `DynamicWindow.ReproducesOldOverspeedBugAndNewPolicy`: v0 = 0.50, max 0.15, decel 0.5, dt 0.1 → mức đạt được thấp nhất 0.45; trước: lệnh 0.15 + mô phỏng v = 0.15 (quãng 1 s: 0.15 m); sau: lệnh 0.15 (cap của LỆNH, gắn cờ `overspeed`) nhưng mô phỏng quãng thật 0.3075 m và đuôi phanh 0.2025 m | `computeWindow()`: chính sách *hard cap cho lệnh, giảm tốc thật cho mô phỏng*; hai điều kiện không được tuyên bố cùng thỏa trong chu kỳ đó. Closed-loop `overspeed_start`, `overspeed_wall` (không va chạm) |
| A4 | P0 | `validate()` không có `isfinite`, thiếu miền cho trọng số/gain/góc, không chặn tải | `validate()` | `Validate.RejectsNonFiniteInEveryDouble` (36 trường × NaN/±Inf), `Validate.RangesRelationsAndLoad`; plugin `ParameterUpdatesAreAtomicAndValidated` | `validateParams()`: hữu hạn, miền, quan hệ chéo, trọng số ≥ 0, ước lượng tải ≤ 100 000 pose/chu kỳ, ≤ 101 mẫu/trục |
| A5 | P0 | `transform_tolerance` dùng như tuổi nhưng chỉ là thời gian chờ; đích tra TF tại stamp của pose cuối path | `buildLocalPath()`, `computeVelocityCommands()` (`tf_->transform(goal_in, ...)`) | plugin `OldPathStampUsesLatestTransform` (path 40 s tuổi, buffer chỉ có TF hiện tại: trước → extrapolation → abort; sau: chạy), `MapToOdomAgeIsCheckedButFutureStampsAreFine` | Tra TF mới nhất **một lần**, dùng chung cho đường và đích; `max_tf_age` (1.0 s) tách khỏi `transform_tolerance` (chờ); `max_pose_age` 0.5 s cho TF odom→base |
| A6 | P0 | Vùng mù phía sau không thành "unknown": `track_unknown_space: false` | `config/nav2_params.yaml` local_costmap | `CollisionModel.FootprintCornerVsCenterAndUnknown` (unknown chỉ bị chặn khi costmap thật sự có ô NO_INFORMATION) | **Không đổi cấu hình** (chưa có dữ liệu scan thật để đánh giá việc bật theo dõi unknown — tia `inf` không xóa ô, có thể làm robot từ chối đi ở không gian mở). Thay vào đó: cảnh báo lúc activate, mô tả chính sách coverage (`requirements_validation.md` R7). Bảo vệ thực tế = không lùi + chỉ quay tại chỗ với robot tròn |
| A7 | P1 | Bỏ qua `GoalChecker`, tự giữ dung sai riêng; latch có thể đứng yên mãi | `computeVelocityCommands()` | `Goal.ToleranceComesFromGoalChecker`, `Goal.LatchReleasedOnDriftAndWhenAlignedOutsideEntry`, `Goal.YawErrorWrapsAcrossPi`; plugin `GoalCheckerTolerancesAreUsed` | Dung sai = `goal_checker->getTolerances()` (dự phòng: tham số, có cảnh báo khi khác); vào ở `xy·0.9`, nhả khi > `xy + 0.05` hoặc khi đã đúng hướng mà vẫn ngoài ngưỡng vào |
| A8 | P1 | Không chống dao động ω | — | `Oscillation.PenalizesImmediateFlipBackAndResets`, `Rotation.DirectionHeldNearPi` | `OscillationGuard` (chi phí mềm, đặt lại theo quãng/góc/thời gian) + giữ chiều xoay khi sai số gần ±π |
| A9 | P1 | Global (0.20 m, không padding) và local (0.20 + 0.10) dùng biên khác nhau | `nav2_params.yaml` | closed-loop `corridor_narrow` (khe 0.54 m: A* cho qua, controller dừng trước khe, không va chạm, không "thành công giả") | **Không đổi geometry** (chưa đo footprint/khoảng hở thật). Đề xuất trong `p2_proposals.md` (#4) |
| A10 | P1 | Baseline Nav2 không dùng generator DWA | `FollowPath` YAML | — | Giữ `FollowPath` (Standard); thêm profile **chỉ trong benchmark** `FollowPathLA` (LimitedAccel, `sim_period 0.1`) |
| A11 | P1 | Không có unit/integration test cho controller | `CMakeLists.txt` | — | `test_dwa_core` (44), `test_dwb_controller_plugin` (12), `dwa_closed_loop_sim`, fixture ROS `test/offline/` |
| A12 | P2 | Global path không xét vật cản mới, không replan | thiết kế | `blocked_wall`, `obstacle_bypass` | 2026-10-15: obstacle layer ở global costmap + replan trong `goal_path_bridge` (`replanning.md`), offline only |

## Phát hiện thêm trong lúc làm

| # | Phát hiện | Bằng chứng | Sửa |
|---|---|---|---|
| B1 | Chi phí vật cản = max theo **chân trời thời gian** ⇒ ứng viên chậm "thấy" ít vùng inflation hơn ⇒ robot giảm tốc tiệm cận 0 ở mép inflation dù lối đi hợp lệ (có trong cả mã trước) | `obstacle_near_path` (sim lõi): trước sửa abort "Failed to make progress" ở x ≈ 1.25 m, mọi seed | `obstacleProbe()`: chi phí vật cản đo trên cung dài cố định `max_vel_x·sim_time` theo độ cong của ứng viên; sau sửa 5/5 thành công, khoảng hở thân ≥ 0.16 m |
| B2 | Mẫu cuối `lo + (hi−lo)·1` có thể lớn hơn `hi` 1 ulp ⇒ lệnh vượt `max_vel` (cùng công thức với mã trước) | `Sampler.AlwaysContainsZeroWhenReachableAndIsUnique` fail ở lần chạy đầu (0.3 > 0.3) | Mẫu cuối = `hi` chính xác |
| B3 | Khóa costmap được giữ suốt chu kỳ, kể cả lúc **chờ TF** (tới 0.3 s) và publish marker | đọc mã trước: `lock_guard` ở đầu `computeVelocityCommands` | Tra TF / publish ngoài khóa; khóa chỉ quanh cắt đường + `DwaCore::compute` |
| B4 | Hai lần `snapshotParams()` trong một chu kỳ (tham số có thể khác nhau giữa các bước) | đọc mã trước: `buildLocalPath()` | Một snapshot mỗi chu kỳ, truyền xuống mọi bước |
| B5 | Tìm điểm gần nhất theo **đỉnh** và min Euclid trong cửa sổ ⇒ có thể nhảy nhánh ở chữ U < 1 m | `PathTracker.HairpinStaysOnCurrentLeg`, `SelfIntersectionDoesNotJumpBranches` | `PathTracker`: chiếu liên tục lên đoạn, lấy cực tiểu đầu tiên dọc đường (trễ 0.1 m), tiến trình không giảm |
| B6 | (Bản đầu của mã mới) watchdog odometry nghe `odom` thay vì `/odometry/filtered`: `controller_server` khai báo `odom_topic` **sau** khi configure plugin | Fixture ROS: lần chạy đầu abort "no odometry received on 'odom'"; plugin test cũ đã khai báo sẵn tham số nên không bắt được | `declare_parameter_if_not_declared("odom_topic")` giống `OdomSubscriber`; plugin test giờ cấp tham số qua override như YAML |
| B7 | `controller_server` (Humble) chờ `isCurrent()` vô hạn khi scan ngừng: không gọi plugin, không publish (kể cả 0), không xử lý cancel | mã S8; kịch bản `stale_scan` của benchmark | Ngoài plugin. Lệnh cuối hết hạn nhờ timeout 0.5 s của `twist_mux` / watchdog driver. Biện pháp: `p2_proposals.md` (#2) |
| B8 | Plan một pose: không có "hành lang" để đo độ lệch | closed-loop `single_pose` | Bỏ kiểm `max_path_deviation` khi plan có 1 pose (đích vẫn phải trong local costmap) |
