ppthanh2810/capstone_project/stage3_navigation/doc/sources.md

# Nguồn tham khảo — CustomDWB (stage3_navigation::DwbController)

Ngày: 2026-10-14. Môi trường triển khai đã kiểm: Ubuntu 22.04, ROS 2 **Humble**,
`ros-humble-nav2-controller` / `dwb_plugins` **1.1.20** (`/opt/ros/humble/share/*/package.xml`).

Quy tắc đã áp dụng: **header đã cài trong `/opt/ros/humble/include` là căn cứ cuối cùng cho API**. Mã nguồn
`.cpp` lấy từ nhánh `humble` của `ros-navigation/navigation2` (tải ngày 2026-10-14, có thể mới hơn bản deb 1.1.20)
chỉ dùng để hiểu **hành vi**; hành vi quan trọng đã được xác nhận lại bằng test/chạy thực tế khi có thể (cột
"Xác nhận"). Không chép YAML từ Rolling/Jazzy, không thêm API chỉ có ở distro mới (`cancel()`,
`newPathReceived()` không tồn tại trong `nav2_core::Controller` Humble — đã kiểm header).

| ID | Nguồn | Đã đọc trong phiên này? | Phần đã dùng | Quyết định áp dụng | Xác nhận |
|---|---|---|---|---|---|
| S1 | Fox, Burgard, Thrun, *The Dynamic Window Approach to Collision Avoidance*, IEEE Robotics & Automation Magazine 4(1), 1997 (bản PDF trên trang công bố của CMU RI) | **Không tải lại** — dùng nội dung đã biết của bài báo | Dynamic window = vận tốc đạt được trong một chu kỳ; *admissible velocities*: chỉ nhận (v, ω) mà robot còn phanh dừng được trước vật cản | Cửa sổ tính từ vận tốc **đo**; thêm **đuôi phanh** (`rolloutCommand`, `checkTrajectory` → `Reject::BRAKING`) gồm trễ + một chu kỳ + giảm tốc theo `decel_lim_*` + `stopping_margin` | Unit test `Braking.*`, `DynamicWindow.*` |
| S2 | DWB README / kiến trúc (`nav2_dwb_controller`, nhánh humble) | Không đọc README; đọc mã nguồn (S4–S6) | Generator + critics; Standard (trajectory rollout với chuyển tiếp gia tốc) vs LimitedAccel (DWA: cửa sổ = 1 `sim_period`, giữ vận tốc ứng viên hằng) | CustomDWB giữ kiến trúc riêng (không có pluginlib critic); so sánh với cả hai generator | Benchmark profile `nav2_dwb`, `nav2_dwb_la` |
| S3 | `nav2_core::Controller` Humble — **header đã cài** `/opt/ros/humble/include/nav2_core/controller.hpp`, `goal_checker.hpp`, `exceptions.hpp` | Có | Chữ ký `configure/cleanup/activate/deactivate/setPlan/computeVelocityCommands/setSpeedLimit`; `GoalChecker::getTolerances`; chỉ có `PlannerException` | Giữ nguyên chữ ký; mọi lỗi runtime → `PlannerException`; dung sai đích lấy từ `getTolerances` | Build + `test_dwb_controller_plugin` (pluginlib nạp lớp) |
| S4 | `dwb_core/src/dwb_local_planner.cpp` (humble) | Có | Prune/transform plan, `trajectory_generator_name` mặc định `dwb_plugins::StandardTrajectoryGenerator` | Baseline `FollowPath` hiện tại = Standard (YAML không khai báo generator) — giữ nguyên | Tham số nạp thực tế được ghi trong `client.json` của benchmark |
| S5 | `dwb_plugins/src/limited_accel_generator.cpp`, `standard_traj_generator.cpp`, `one_d_velocity_iterator.hpp`, `kinematic_parameters.cpp` (humble) | Có | LimitedAccel: tham số `<plugin>.sim_period` (mặc định 1/controller_frequency), `computeNewVelocity` trả nguyên vận tốc ứng viên (rollout hằng) | Profile benchmark `FollowPathLA` = bản sao `FollowPath` + `trajectory_generator_name: dwb_plugins::LimitedAccelGenerator`, `sim_period: 0.1` (10 Hz). **Chỉ có trong YAML sinh cho benchmark**, không thêm vào cấu hình robot | `GetParameters` lúc chạy: `FollowPathLA.trajectory_generator_name = dwb_plugins::LimitedAccelGenerator`, `sim_period = 0.1` |
| S6 | `dwb_critics/src/oscillation.cpp`, `rotate_to_goal.cpp` (humble) | Có (BaseObstacle/ObstacleFootprint: **không** đọc) | Oscillation: theo dõi đổi dấu, đặt lại theo `oscillation_reset_dist` 0.05 / `reset_angle` 0.2 / `reset_time` (mặc định −1 = tắt) | `OscillationGuard`: cùng ý tưởng, nhưng là chi phí mềm (`oscillation_scale`) và `reset_time` **bắt buộc > 0** (không khóa chiều xoay vô hạn). Trọng số Nav2 **không** chép sang (thang điểm khác) | `Oscillation.*`, `Rotation.DirectionHeldNearPi` |
| S7 | Obstacle layer / Tuning guide (docs.nav2.org) | **Không** đọc tài liệu web; đọc `costmap_2d_ros.cpp` (humble) + header đã cài (`getUseRadius`, `LayeredCostmap::isTrackingUnknown/getInscribedRadius/isCurrent`) | `track_unknown_space`, footprint/padding, `isCurrent` | Plugin báo cảnh báo khi `unknown_is_obstacle` nhưng costmap không theo dõi unknown; chế độ va chạm `auto` (tròn → ô tâm, đa giác → thêm viền footprint) | Log lúc activate (benchmark): `collision check: center (inscribed 0.294 m, circumscribed 0.341 m)` |
| S8 | `nav2_controller/src/controller_server.cpp` (humble) | Có | Vòng `computeControl`: chờ `costmap_ros_->isCurrent()` **không giới hạn, không publish, không xét cancel**; `PlannerException` → lệnh 0 trong `failure_tolerance` rồi abort + `publishZeroVelocity`; `odom_topic` khai báo trong `on_configure` **sau** khi configure plugin; không kiểm tra tuổi odometry; `isGoalReached` dùng goal checker | Watchdog odometry + tuổi pose/TF đặt **trong plugin** (server không có); chờ costmap stale là việc của server → ghi rõ là giới hạn, biện pháp ở P2 | Bug thật tìm thấy nhờ fixture ROS: plugin đọc `odom_topic` = `odom` (chưa khai báo) → sửa bằng `declare_parameter_if_not_declared`; kịch bản `stale_scan` của benchmark |
| S9 | Test `dwb_plugins` nhánh humble (`velocity_iterator_test`, `twist_gen`, `kinematic_parameters_test`, `speed_limit_test`) | **Không** tải | — | Test của dự án tự viết theo hành vi (biên cửa sổ, speed limit, mẫu 0), không sao chép | — |
| S10 | DWB configuration (docs.nav2.org) | **Không** đọc | — | Không lấy số của TurtleBot; mọi giới hạn ghi NOT_VERIFIED | — |
| + | `nav2_controller/plugins/simple_goal_checker.cpp`, `simple_progress_checker.cpp` (humble) | Có | Goal checker stateful: xy chốt một lần rồi chỉ xét yaw; `getTolerances` trả `xy` ở `position.x`, yaw dưới dạng quaternion quanh z. Progress checker: xoay tại chỗ không tính là "di chuyển" | Latch/nhả `ROTATE_TO_GOAL` theo dung sai của checker; nhả latch khi đúng hướng mà ngoài ngưỡng vào (tránh đứng yên chờ abort) | `Goal.*`, plugin test `GoalCheckerTolerancesAreUsed` |
| + | `nav2_util/src/robot_utils.cpp`, `nav_2d_utils/src/tf_help.cpp` (humble) | Có | `getRobotPose` dùng TF mới nhất; stamp pose = stamp TF | Plugin kiểm `now − pose.stamp ≤ max_pose_age` | plugin test `StaleOrMissingInputsStopTheController` |
| + | `nav2_amcl/src/amcl_node.cpp` (humble) + `stage2_slam/config/amcl_params.yaml` (`transform_tolerance: 1.0`) | Có | AMCL đóng dấu `map→odom` = thời điểm scan + `transform_tolerance` (tương lai) | Tuổi âm của TF map→odom là hợp lệ; `max_tf_age` 1.0 s ⇒ TF chỉ bị coi cũ sau ~2 s khi AMCL ngừng | plugin test `MapToOdomAgeIsCheckedButFutureStampsAreFine` |
| + | `/opt/ros/humble/include/nav2_costmap_2d/nav2_costmap_2d/costmap_filters/filter_values.hpp` (**đã cài**) | Có | `NO_SPEED_LIMIT = 0.0` | `setSpeedLimit(0.0, *)` = **bỏ** giới hạn (không phải dừng); percentage ≥ 100 = bỏ; âm/NaN = bỏ qua | plugin test `SpeedLimitHumbleContract` |

URL gốc: <https://github.com/ros-navigation/navigation2/tree/humble/nav2_dwb_controller>,
<https://github.com/ros-navigation/navigation2/blob/humble/nav2_controller/src/controller_server.cpp>.

Nguồn P2 (Velocity Smoother, Collision Monitor, BT replanning): chưa đọc; phải tra đúng tài liệu Humble trước
khi dùng (xem `p2_proposals.md`).
