ppthanh2810/capstone_project/hardware/robot_description/meshes/camera_d435.stl

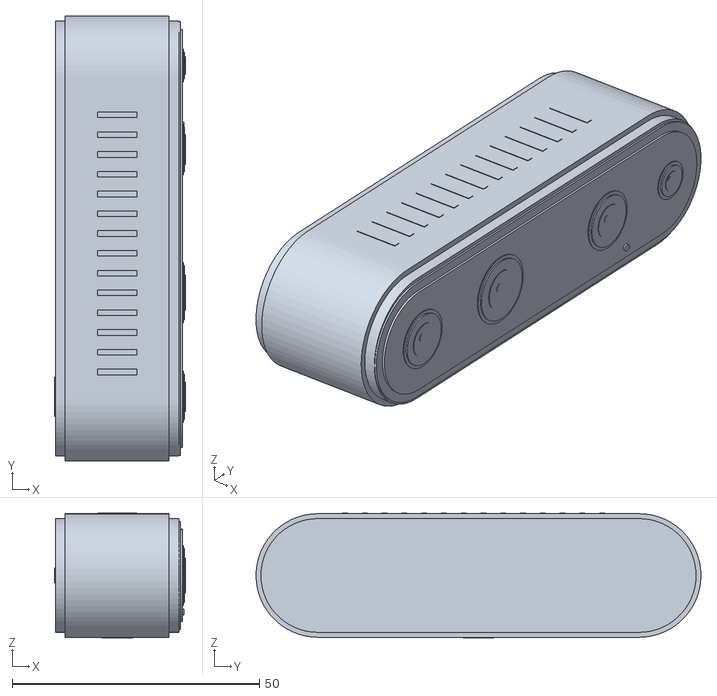
[picture p1: CAD file, 2026-09-23]
hardware/robot_description/meshes/camera_d435.stl
26.6 x 90.0 x 25.2
