ppthanh2810/capstone_project/hardware/robot_description/meshes/rplidar.stl

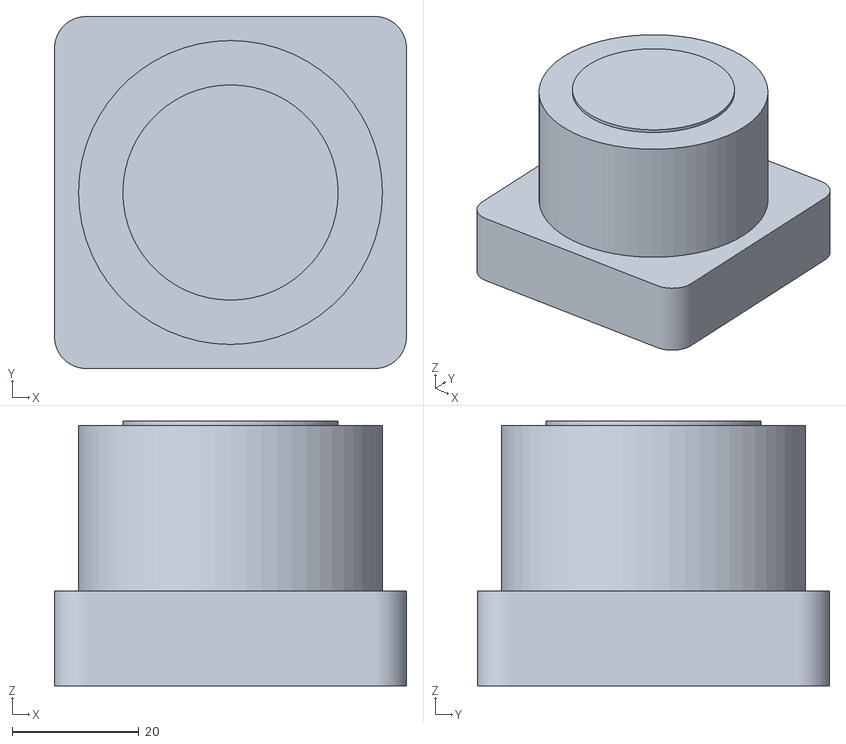
[picture p2: CAD file, 2026-09-23]
hardware/robot_description/meshes/rplidar.stl
55.6 x 55.6 x 41.8
