ppthanh2810/capstone_project/hardware/robot_description/meshes/motor_plate.stl

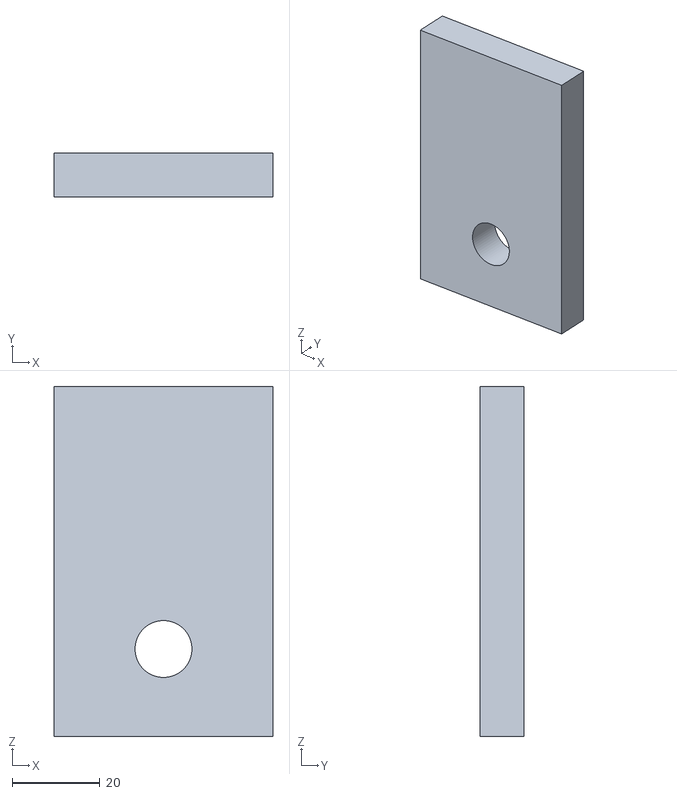
[picture p3: CAD file, 2026-09-23]
hardware/robot_description/meshes/motor_plate.stl
50.0 x 10.0 x 80.0
