ppthanh2810/capstone_project/hardware/robot_description/meshes/camera_mount_photo.stl

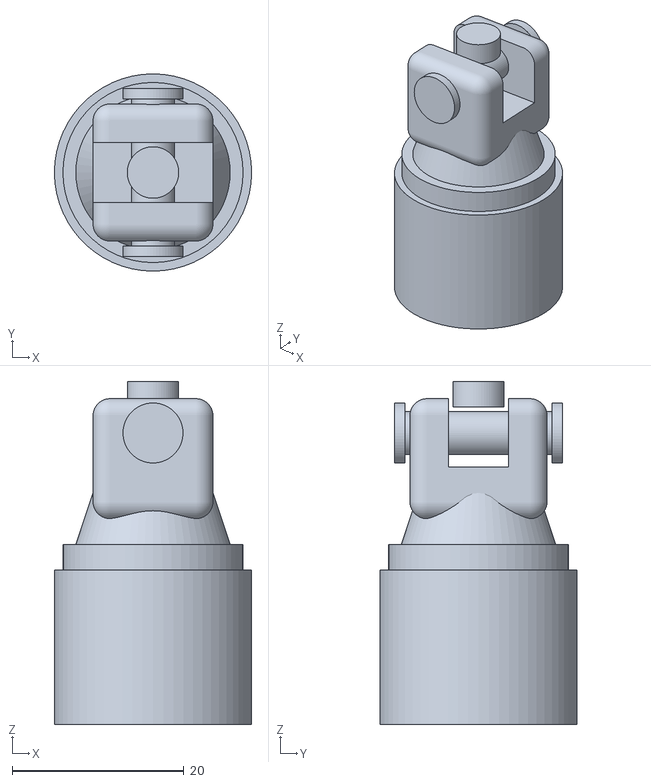
[picture p4: CAD file, 2026-09-23]
hardware/robot_description/meshes/camera_mount_photo.stl
23.0 x 23.0 x 40.0
