ppthanh2810/capstone_project/hardware/robot_description/meshes/drive_wheel.stl

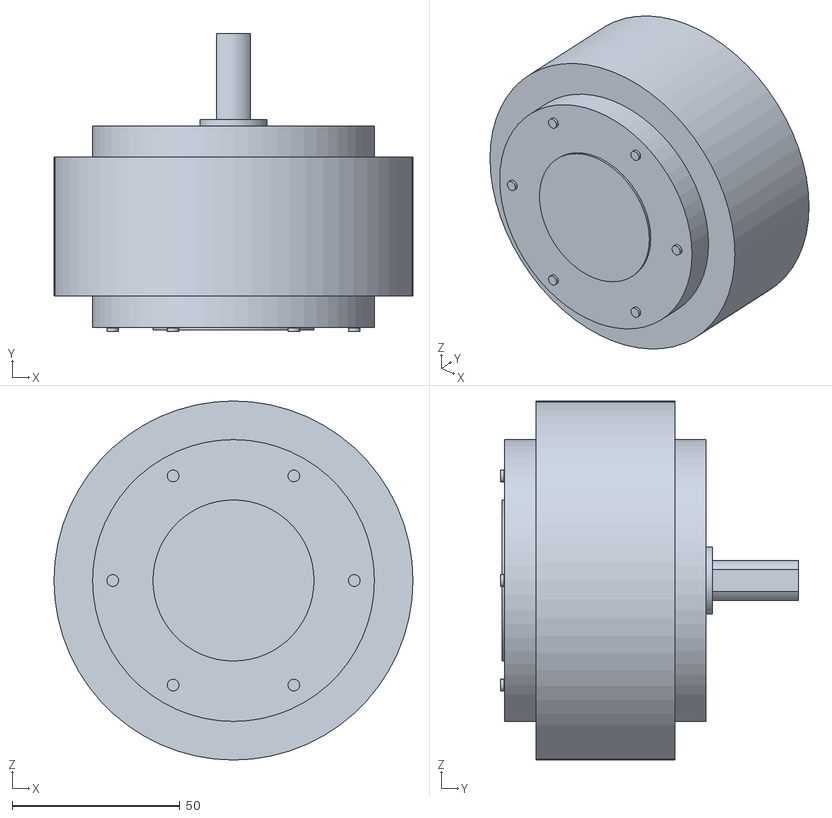
[picture p5: CAD file, 2026-09-23]
hardware/robot_description/meshes/drive_wheel.stl
107.0 x 88.7 x 107.0
