ppthanh2810/capstone_project/hardware/robot_description/meshes/lidar_plate.stl

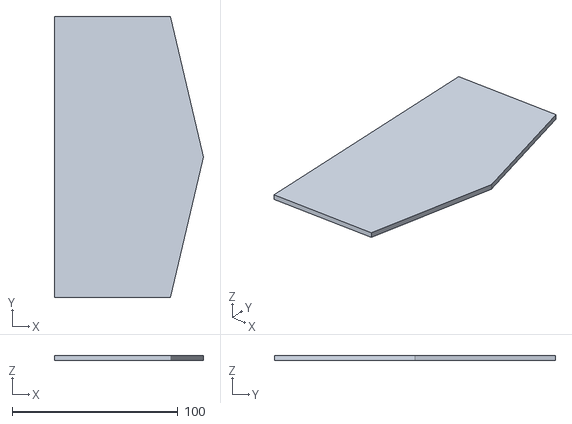
[picture p6: CAD file, 2026-09-23]
hardware/robot_description/meshes/lidar_plate.stl
90.0 x 170.0 x 3.00
