ppthanh2810/capstone_project/stage3_navigation/doc/benchmark/m2_camera_2026-10-20/summary_fusion.md

| scenario | profile | ok/exp | succeeded | statuses | coll | min clr m | t s | ct rms m | ct max m | ω flips | stop after event s | stop dist m | compute p99/max ms | cmd period p99 ms |
|---|---|---|---|---|---|---|---|---|---|---|---|---|---|---|
| cam_low_box_near_path | custom | 3/3 | 3 | succeeded | 0 | 0.160 | 26.1 | 0.001 | 0.001 | 0.0 | n/a | n/a | 2.93/3.77 | 102 |
| cam_low_box_on_path | custom | 3/3 | 0 | aborted | 0 | 0.100 | 18.9 | 0.000 | 0.000 | 0.0 | 0.05 | 0.000 | 3.03/3.30 | 103 |
| cam_table_on_path | custom | 3/3 | 0 | aborted | 0 | 0.099 | 18.9 | 0.000 | 0.000 | 0.0 | 0.05 | 0.000 | 2.94/3.06 | 102 |
| cam_tall_box_on_path | custom | 3/3 | 0 | aborted | 0 | 0.100 | 18.9 | 0.000 | 0.000 | 0.0 | 0.05 | 0.000 | 3.23/4.12 | 102 |
| obstacle_near_path | custom | 3/3 | 3 | succeeded | 0 | 0.160 | 26.1 | 0.001 | 0.001 | 0.0 | n/a | n/a | 2.94/3.03 | 102 |
| straight | custom | 3/3 | 3 | succeeded | 0 | n/a | 19.5 | 0.000 | 0.000 | 0.0 | n/a | n/a | 3.39/9.29 | 103 |
