ppthanh2810/capstone_project/stage3_navigation/doc/benchmark/m2_camera_2026-10-20/summary_none.md

| scenario | profile | ok/exp | succeeded | statuses | coll | min clr m | t s | ct rms m | ct max m | ω flips | stop after event s | stop dist m | compute p99/max ms | cmd period p99 ms |
|---|---|---|---|---|---|---|---|---|---|---|---|---|---|---|
| cam_low_box_near_path | custom | 3/3 | 3 | succeeded | 0 | 0.160 | 26.1 | 0.000 | 0.000 | 0.0 | n/a | n/a | 3.12/5.65 | 103 |
| cam_low_box_on_path | custom | 0/3 | 3 | succeeded | 3 | -0.349 | 26.1 | 0.000 | 0.000 | 0.0 | n/a | n/a | 3.66/5.67 | 103 |
| cam_table_on_path | custom | 0/3 | 3 | succeeded | 3 | -0.499 | 26.1 | 0.000 | 0.000 | 0.0 | n/a | n/a | 3.29/7.24 | 102 |
| cam_tall_box_on_path | custom | 3/3 | 0 | aborted | 0 | 0.100 | 18.9 | 0.000 | 0.000 | 0.0 | 0.03 | 0.000 | 3.11/3.22 | 102 |
| obstacle_near_path | custom | 3/3 | 3 | succeeded | 0 | 0.161 | 26.1 | 0.001 | 0.001 | 0.0 | n/a | n/a | 3.20/3.80 | 102 |
| straight | custom | 3/3 | 3 | succeeded | 0 | n/a | 19.5 | 0.000 | 0.000 | 0.0 | n/a | n/a | 3.20/3.30 | 102 |
