ppthanh2810/capstone_project/stage3_navigation/doc/benchmark/m2_camera_2026-10-20/runs_fusion.csv

cmd_period_max_ms | cmd_period_p50_ms | cmd_period_p99_ms | collision | compute_max_ms | compute_over_100ms | compute_p50_ms | compute_p95_ms | compute_p99_ms | cross_track_max_m | cross_track_rms_m | expect | final_xy_error_m | final_yaw_error_rad | graph_ok | last_nonzero_cmd_after_event_s | limit_violations | meets_expectation | min_clearance_m | missed_rate_warnings | n_cmds | nonfinite_cmds | profile | reverse_cmds | robot_stop_after_event_s | run | scenario | seed | status | stop_distance_m | time_s | w_sign_flips
102.69104700091702 | 100.01842200017563 | 102.03048976980426 | False | 3.125 | 0 | 1.441 | 2.24525 | 2.669 | 0.0014 | 0.0007072964012588462 | success | 0.1259999999999999 | 0.001 | True |  | 0 | True | 0.1605 | 0 | 263 | 0 | custom | 0 |  | 0 | cam_low_box_near_path | 1000 | succeeded |  | 26.133445423000012 | 0
103.39234599996416 | 99.99821249948582 | 102.41837540987035 | False | 3.679 | 0 | 1.818 | 2.548 | 2.899999999999993 | 0.0014 | 0.0006807000003095751 | success | 0.1259999999999999 | 0.001 | True |  | 0 | True | 0.1604 | 0 | 263 | 0 | custom | 0 |  | 1 | cam_low_box_near_path | 1001 | succeeded |  | 26.133069989000433 | 0
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
