ppthanh2810/capstone_project/stage3_navigation/doc/benchmark/m2_camera_2026-10-20/runs_none.csv

cmd_period_max_ms | cmd_period_p50_ms | cmd_period_p99_ms | collision | compute_max_ms | compute_over_100ms | compute_p50_ms | compute_p95_ms | compute_p99_ms | cross_track_max_m | cross_track_rms_m | expect | final_xy_error_m | final_yaw_error_rad | graph_ok | last_nonzero_cmd_after_event_s | limit_violations | meets_expectation | min_clearance_m | missed_rate_warnings | n_cmds | nonfinite_cmds | profile | reverse_cmds | robot_stop_after_event_s | run | scenario | seed | status | stop_distance_m | time_s | w_sign_flips
102.84428999875672 | 99.98098400046729 | 102.17618335016596 | False | 3.198 | 0 | 1.563 | 2.225 | 2.809199999999997 | 1.3877787807814457e-17 | 6.961554787920805e-19 | success | 0.12639999999999985 | 0.0 | True |  | 0 | True | 0.16 | 0 | 263 | 0 | custom | 0 |  | 0 | cam_low_box_near_path | 1000 | succeeded |  | 26.133248925998487 | 0
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
