ppthanh2810/capstone_project/stage3_navigation/doc/benchmark/m2_camera_2026-10-20/runs_voxel.csv

cmd_period_max_ms | cmd_period_p50_ms | cmd_period_p99_ms | collision | compute_max_ms | compute_over_100ms | compute_p50_ms | compute_p95_ms | compute_p99_ms | cross_track_max_m | cross_track_rms_m | expect | final_xy_error_m | final_yaw_error_rad | graph_ok | last_nonzero_cmd_after_event_s | limit_violations | meets_expectation | min_clearance_m | missed_rate_warnings | n_cmds | nonfinite_cmds | profile | reverse_cmds | robot_stop_after_event_s | run | scenario | seed | status | stop_distance_m | time_s | w_sign_flips
101.4368830001331 | 99.97113600002194 | 101.32016876981652 | False | 3.237 | 0 | 2.0335 | 2.7735 | 3.0848199999999992 | 0.0014 | 0.0006972768665893676 | success | 0.1261000000000001 | 0.001 | True |  | 0 | True | 0.1605 | 0 | 263 | 0 | custom | 0 |  | 0 | cam_low_box_near_path | 1000 | succeeded |  | 26.13332866500059 | 0
101.85800299950643 | 100.02214399992226 | 101.38245018035377 | False | 3.168 | 0 | 1.9245 | 2.7275 | 3.0175999999999994 | 0.0014 | 0.0007009025380294254 | success | 0.12630000000000008 | 0.001 | True |  | 0 | True | 0.1605 | 0 | 263 | 0 | custom | 0 |  | 1 | cam_low_box_near_path | 1001 | succeeded |  | 26.133537860001525 | 0
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
