ppthanh2810/capstone_project/stage3_navigation/doc/benchmark/ros_2026-10-14/runs.csv

cmd_period_max_ms | cmd_period_p50_ms | cmd_period_p99_ms | collision | compute_max_ms | compute_over_100ms | compute_p50_ms | compute_p95_ms | compute_p99_ms | cross_track_max_m | cross_track_rms_m | expect | final_xy_error_m | final_yaw_error_rad | graph_ok | last_nonzero_cmd_after_event_s | limit_violations | meets_expectation | min_clearance_m | missed_rate_warnings | n_cmds | nonfinite_cmds | profile | reverse_cmds | robot_stop_after_event_s | run | scenario | seed | status | stop_distance_m | time_s | w_sign_flips
103.60498800037021 | 99.98465099943132 | 101.82467375134364 | False | 2.638 | 0 | 1.74 | 2.1744 | 2.3698 | 1.3877787807814457e-17 | 8.798734199459811e-19 | stop | 2.2994000000000003 | 0.0 | True | 0.0 | 0 | True | 0.0994 | 0 | 207 | 0 | custom | 0 | 0.046248578999438905 | 0 | blocked_wall | 1000 | aborted | 0.0 | 20.633145230000082 | 0
105.4409640000813 | 99.95048549990315 | 101.39830209836873 | False | 2.9 | 0 | 1.808 | 2.4372 | 2.7728800000000002 | 1.3877787807814457e-17 | 7.56369401274683e-19 | stop | 2.2995 | 0.0 | True | 0.0 | 0 | True | 0.0995 | 0 | 207 | 0 | custom | 0 | 0.04673193099915807 | 1 | blocked_wall | 1001 | aborted | 0.0 | 20.63352869799928 | 0
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
