ppthanh2810/capstone_project/stage3_navigation/doc/benchmark/core_2026-10-14/nominal/runs.csv

scenario | robot | seed | expect_success | success | result | time_s | collisions | min_clearance_m | cross_track_rms_m | cross_track_max_m | w_sign_flips | limit_violations | nonfinite_cmds | cmd_rate_exceed | blocked_cycles | final_xy_error_m | final_yaw_error_rad | stop_latency_s | stop_distance_m | path_length_m | n_cycles | compute_p50_ms | compute_p95_ms | compute_p99_ms | compute_max_ms | missed_deadlines
straight | nominal | 1000 | 1 | 1 | succeeded | 19.50 | 0 | inf | 0.0078 | 0.0258 | 0 | 0 | 0 | 0 | 0 | 0.1257 | 0.0005 | -1.000 | -1.0000 | 2.865 | 196 | 1.340 | 1.993 | 2.361 | 2.448 | 0
straight | nominal | 1001 | 1 | 1 | succeeded | 19.40 | 0 | inf | 0.0128 | 0.0426 | 0 | 0 | 0 | 0 | 0 | 0.1299 | 0.0004 | -1.000 | -1.0000 | 2.854 | 195 | 1.333 | 1.456 | 1.548 | 1.785 | 0
straight | nominal | 1002 | 1 | 1 | succeeded | 19.40 | 0 | inf | 0.0025 | 0.0078 | 0 | 0 | 0 | 2 | 0 | 0.1303 | 0.0003 | -1.000 | -1.0000 | 2.855 | 195 | 1.329 | 1.420 | 1.465 | 1.575 | 0
straight | nominal | 1003 | 1 | 1 | succeeded | 19.40 | 0 | inf | 0.0069 | 0.0235 | 0 | 0 | 0 | 1 | 0 | 0.1246 | 0.0002 | -1.000 | -1.0000 | 2.850 | 195 | 1.332 | 1.427 | 1.496 | 1.514 | 0
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
