ppthanh2810/capstone_project/stage3_navigation/doc/benchmark/core_2026-10-14/nominal_traces/runs.csv

scenario | robot | seed | expect_success | success | result | time_s | collisions | min_clearance_m | cross_track_rms_m | cross_track_max_m | w_sign_flips | limit_violations | nonfinite_cmds | cmd_rate_exceed | blocked_cycles | final_xy_error_m | final_yaw_error_rad | stop_latency_s | stop_distance_m | path_length_m | n_cycles | compute_p50_ms | compute_p95_ms | compute_p99_ms | compute_max_ms | missed_deadlines
straight | nominal | 1000 | 1 | 1 | succeeded | 19.50 | 0 | inf | 0.0078 | 0.0258 | 0 | 0 | 0 | 0 | 0 | 0.1257 | 0.0005 | -1.000 | -1.0000 | 2.865 | 196 | 1.337 | 1.585 | 1.765 | 2.193 | 0
l_turn | nominal | 1000 | 1 | 1 | succeeded | 24.80 | 0 | inf | 0.0280 | 0.1294 | 0 | 0 | 0 | 0 | 0 | 0.1293 | 0.0013 | -1.000 | -1.0000 | 3.664 | 249 | 1.460 | 1.626 | 1.749 | 1.767 | 0
s_curve | nominal | 1000 | 1 | 1 | succeeded | 36.90 | 0 | inf | 0.0408 | 0.0805 | 4 | 0 | 0 | 0 | 0 | 0.1130 | 0.0971 | -1.000 | -1.0000 | 5.213 | 370 | 1.492 | 1.612 | 1.745 | 1.928 | 0
self_intersect | nominal | 1000 | 1 | 1 | succeeded | 49.00 | 0 | inf | 0.0380 | 0.1334 | 0 | 0 | 0 | 0 | 0 | 0.1250 | 0.0013 | -1.000 | -1.0000 | 7.290 | 491 | 1.488 | 1.714 | 1.827 | 2.270 | 0
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
