ppthanh2810/capstone_project/stage3_navigation/doc/benchmark/core_2026-10-14/sluggish/runs.csv

scenario | robot | seed | expect_success | success | result | time_s | collisions | min_clearance_m | cross_track_rms_m | cross_track_max_m | w_sign_flips | limit_violations | nonfinite_cmds | cmd_rate_exceed | blocked_cycles | final_xy_error_m | final_yaw_error_rad | stop_latency_s | stop_distance_m | path_length_m | n_cycles | compute_p50_ms | compute_p95_ms | compute_p99_ms | compute_max_ms | missed_deadlines
straight | sluggish | 1000 | 1 | 1 | succeeded | 19.70 | 0 | inf | 0.0083 | 0.0257 | 0 | 0 | 0 | 0 | 0 | 0.1093 | 0.0004 | -1.000 | -1.0000 | 2.882 | 198 | 1.353 | 1.467 | 1.530 | 1.591 | 0
straight | sluggish | 1001 | 1 | 1 | succeeded | 19.60 | 0 | inf | 0.0136 | 0.0426 | 1 | 0 | 0 | 0 | 0 | 0.1139 | 0.0003 | -1.000 | -1.0000 | 2.870 | 197 | 1.351 | 1.485 | 1.559 | 1.714 | 0
straight | sluggish | 1002 | 1 | 1 | succeeded | 19.60 | 0 | inf | 0.0026 | 0.0078 | 0 | 0 | 0 | 0 | 0 | 0.1125 | 0.0002 | -1.000 | -1.0000 | 2.873 | 197 | 1.345 | 1.420 | 1.474 | 1.489 | 0
straight | sluggish | 1003 | 1 | 1 | succeeded | 19.50 | 0 | inf | 0.0073 | 0.0235 | 0 | 0 | 0 | 0 | 0 | 0.1140 | 0.0005 | -1.000 | -1.0000 | 2.861 | 196 | 1.345 | 1.435 | 1.464 | 1.512 | 0
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
