ppthanh2810/capstone_project/stage3_navigation/doc/benchmark/core_2026-10-14/nominal_traces/traces/corridor_ok_1000.csv

t | x | y | theta | v | w | v_cmd | w_cmd | phase
0 | 0.0095601 | -0.0255043 | -0.0207068 | 0 | 0 | 0.05 | 0.05 | FOLLOW_PATH
0.1 | 0.0095611 | -0.0255043 | -0.0207048 | 0.001 | 0.002 | 0.0532477 | 0.0424838 | FOLLOW_PATH
0.2 | 0.0121607 | -0.0255525 | -0.0168588 | 0.051 | 0.048 | 0.101324 | 0.0395043 | FOLLOW_PATH
0.3 | 0.0174806 | -0.0256308 | -0.0125968 | 0.0542477 | 0.0404838 | 0.101824 | 0.0431749 | FOLLOW_PATH
0.4 | 0.0253968 | -0.0257132 | -0.00864338 | 0.101824 | 0.0415043 | 0.15 | 0.142331 | FOLLOW_PATH
0.5 | 0.03558 | -0.0257793 | -0.00432557 | 0.102824 | 0.0451749 | 0.149782 | 0.125598 | FOLLOW_PATH
0.6 | 0.048354 | -0.0257804 | 0.00518539 | 0.149782 | 0.140331 | 0.15 | 0.110569 | FOLLOW_PATH
0.7 | 0.0633313 | -0.0256072 | 0.0178522 | 0.15 | 0.123598 | 0.15 | 0.0927967 | FOLLOW_PATH
0.8 | 0.0783271 | -0.0252553 | 0.0289925 | 0.15 | 0.108569 | 0.15 | 0.0786874 | FOLLOW_PATH
0.9 | 0.0933185 | -0.0247491 | 0.0383947 | 0.15 | 0.0907967 | 0.15 | 0.062816 | FOLLOW_PATH
1 | 0.108305 | -0.0241133 | 0.0463349 | 0.15 | 0.0766874 | 0.15 | 0.0462452 | FOLLOW_PATH
1.1 | 0.123287 | -0.0233701 | 0.0527108 | 0.15 | 0.060816 | 0.15 | 0.0401923 | FOLLOW_PATH
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
