ppthanh2810/capstone_project/stage3_navigation/doc/benchmark/core_2026-10-14/nominal_traces/traces/goal_near_1000.csv

t | x | y | theta | v | w | v_cmd | w_cmd | phase
0 | 0 | 0 | 0 | 0 | 0 | 0 | 0.0974496 | ROTATE_TO_GOAL
0.1 | 0 | 0 | 2e-06 | 0 | 0.002 | 0 | 0.101005 | ROTATE_TO_GOAL
0.2 | 0 | 0 | 0.00519325 | 0 | 0.0994496 | 0 | 0.201697 | ROTATE_TO_GOAL
0.3 | 0 | 0 | 0.0152941 | 0 | 0.103005 | 0 | 0.203329 | ROTATE_TO_GOAL
0.4 | 0 | 0 | 0.0305946 | 0 | 0.203005 | 0 | 0.300581 | ROTATE_TO_GOAL
0.5 | 0 | 0 | 0.0509291 | 0 | 0.205329 | 0 | 0.305129 | ROTATE_TO_GOAL
0.6 | 0 | 0 | 0.0764523 | 0 | 0.302581 | 0 | 0.399539 | ROTATE_TO_GOAL
0.7 | 0 | 0 | 0.106964 | 0 | 0.307129 | 0 | 0.407514 | ROTATE_TO_GOAL
0.8 | 0 | 0 | 0.142649 | 0 | 0.401539 | 0 | 0.5 | ROTATE_TO_GOAL
0.9 | 0 | 0 | 0.183385 | 0 | 0.409514 | 0 | 0.5 | ROTATE_TO_GOAL
1 | 0 | 0 | 0.229291 | 0 | 0.5 | 0 | 0.5 | ROTATE_TO_GOAL
1.1 | 0 | 0 | 0.279291 | 0 | 0.5 | 0 | 0.5 | ROTATE_TO_GOAL
1.2 | 0 | 0 | 0.329291 | 0 | 0.5 | 0 | 0.5 | ROTATE_TO_GOAL
1.3 | 0 | 0 | 0.379291 | 0 | 0.5 | 0 | 0.5 | ROTATE_TO_GOAL
1.4 | 0 | 0 | 0.429291 | 0 | 0.5 | 0 | 0.5 | ROTATE_TO_GOAL
1.5 | 0 | 0 | 0.479291 | 0 | 0.5 | 0 | 0.5 | ROTATE_TO_GOAL
1.6 | 0 | 0 | 0.529291 | 0 | 0.5 | 0 | 0.5 | ROTATE_TO_GOAL
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
