ppthanh2810/capstone_project/stage3_navigation/doc/benchmark/core_2026-10-14/nominal_traces/traces/goal_yaw_pi_1000.csv

t | x | y | theta | v | w | v_cmd | w_cmd | phase
0 | 0 | 0 | 0 | 0 | 0 | 0.05 | 0 | FOLLOW_PATH
0.1 | 1e-06 | 0 | 0 | 0.001 | 0 | 0.0489293 | 0 | FOLLOW_PATH
0.2 | 0.002599 | 0 | 0 | 0.049 | 0 | 0.0994749 | 0 | FOLLOW_PATH
0.3 | 0.007493 | 0 | 0 | 0.0499293 | 0 | 0.100413 | 0 | FOLLOW_PATH
0.4 | 0.0149859 | 0 | 0 | 0.0999293 | 0 | 0.15 | 0 | FOLLOW_PATH
0.5 | 0.0250278 | 0 | 0 | 0.101413 | 0 | 0.15 | 0 | FOLLOW_PATH
0.6 | 0.0376668 | 0 | 0 | 0.15 | 0 | 0.15 | 0 | FOLLOW_PATH
0.7 | 0.0526668 | 0 | 0 | 0.15 | 0 | 0.15 | 0 | FOLLOW_PATH
0.8 | 0.0676668 | 0 | 0 | 0.15 | 0 | 0.15 | 0 | FOLLOW_PATH
0.9 | 0.0826668 | 0 | 0 | 0.15 | 0 | 0.15 | 0 | FOLLOW_PATH
1 | 0.0976668 | 0 | 0 | 0.15 | 0 | 0.15 | 0 | FOLLOW_PATH
1.1 | 0.112667 | 0 | 0 | 0.15 | 0 | 0.15 | 0 | FOLLOW_PATH
1.2 | 0.127667 | 0 | 0 | 0.15 | 0 | 0.15 | 0 | FOLLOW_PATH
1.3 | 0.142667 | 0 | 0 | 0.15 | 0 | 0.15 | 0 | FOLLOW_PATH
1.4 | 0.157667 | 0 | 0 | 0.15 | 0 | 0.15 | 0 | FOLLOW_PATH
1.5 | 0.172667 | 0 | 0 | 0.15 | 0 | 0.15 | 0 | FOLLOW_PATH
1.6 | 0.187667 | 0 | 0 | 0.15 | 0 | 0.15 | 0 | FOLLOW_PATH
1.7 | 0.202667 | 0 | 0 | 0.15 | 0 | 0.15 | 0 | FOLLOW_PATH
1.8 | 0.217667 | 0 | 0 | 0.15 | 0 | 0.15 | 0 | FOLLOW_PATH
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
