ppthanh2810/capstone_project/(commit log)

2026-09-15 stage 0 and zlac8015d_hw
2026-09-23 odom + tf
    [camera_d435.stl, camera_mount_photo.stl, drive_wheel.stl, lidar_plate.stl, motor_plate.stl, robot.urdf, robot_desciption.scad, rplidar.stl]
2026-09-28 stage2 done
2026-10-02 stage2 overview
2026-10-21 stage3 2nd camera
2026-10-26 readme.md stage3
2026-10-28 readme stage1 2 3
2026-10-28 readme tổng quát
2026-11-02 stage4_gazebo: S0 mô phỏng Gazebo (driver ZLAC giả lập, world, URDF sim, launch, test) + claude_stage4.md
2026-11-02 stage4 2
2026-11-02 stage4 s2 done
2026-11-02 stage4 s3
2026-11-03 stage4 house
2026-11-03 stage4 done
